cactorium/auto-orchestra/README.md

WIP thing, honestly just publishing just in case my laptop dies
