cactorium/auto-orchestra/pcb/transmitter/LSM303AGR_Footprint.pdf

LSM303AGR
LGA-12 (2x2x1 mm) Recommendation Footprint Design for HTC 1

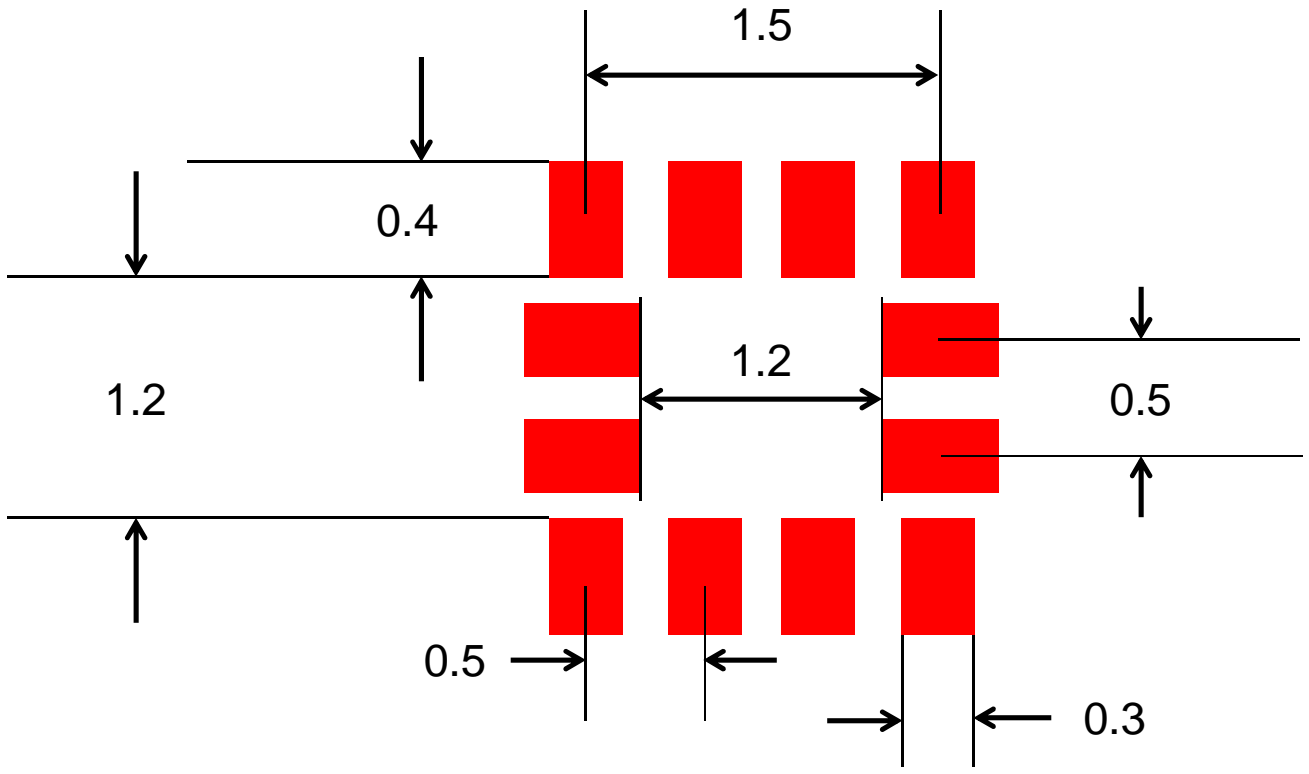
[picture p1: figure]

Presentation Title 29/07/2015

Note : Dimensions are shown in millimeters (mm)
