cactorium/auto-orchestra/pcb/transmitter/controller.pdf

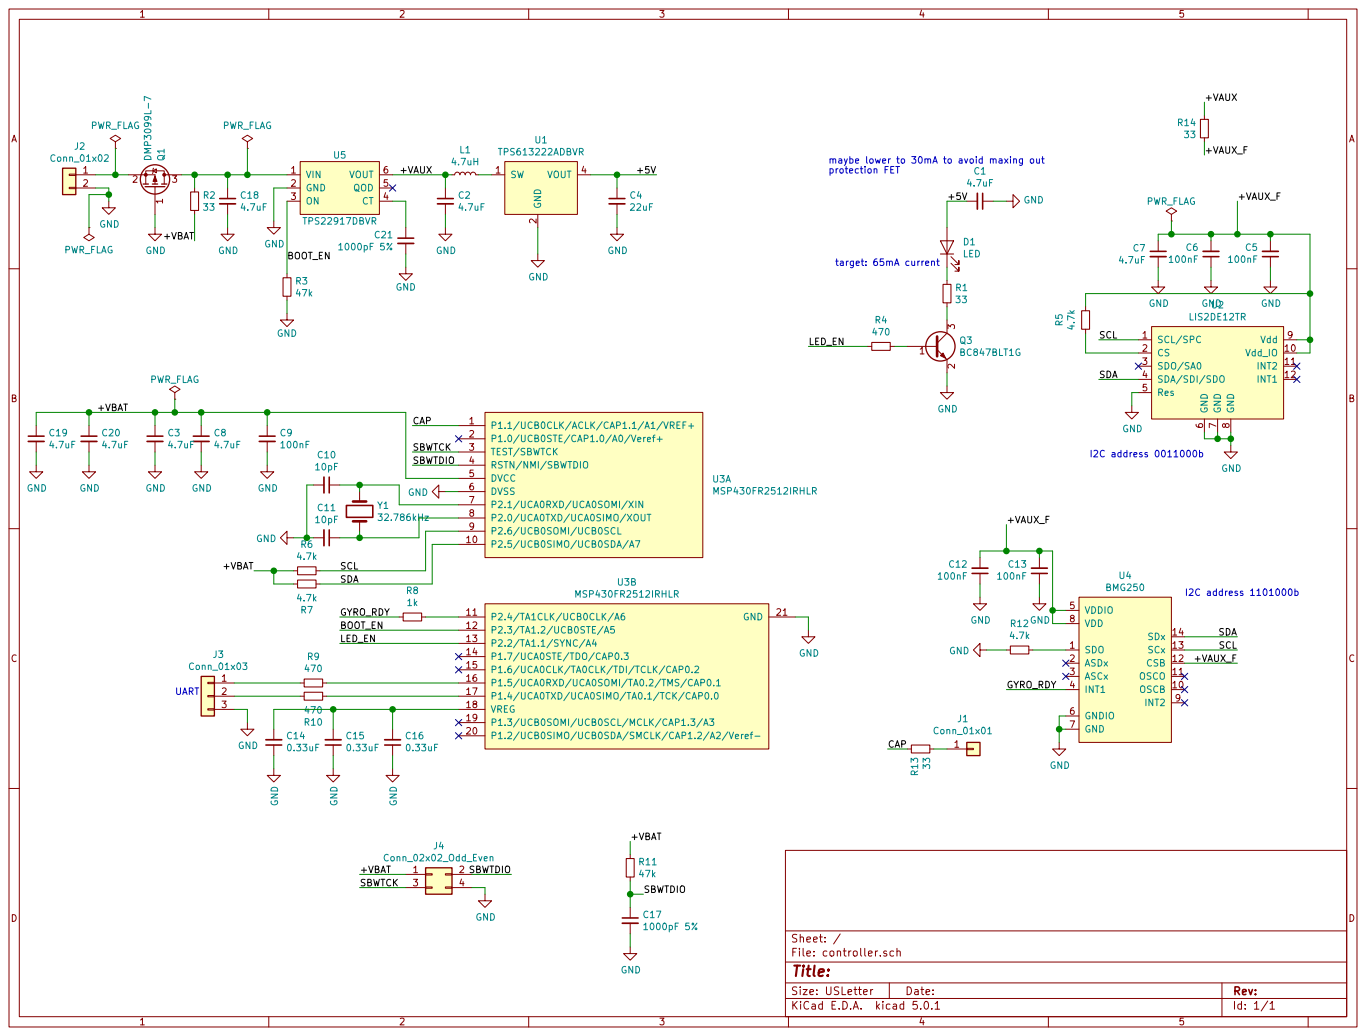
[picture p2: page 1]

4.7k maybe lower to 30mA to avoid maxing out

Id: 1/1 Title: File: controller.sch Sheet: /
