cactorium/auto-orchestra/pcb/receiver/receiver.pdf

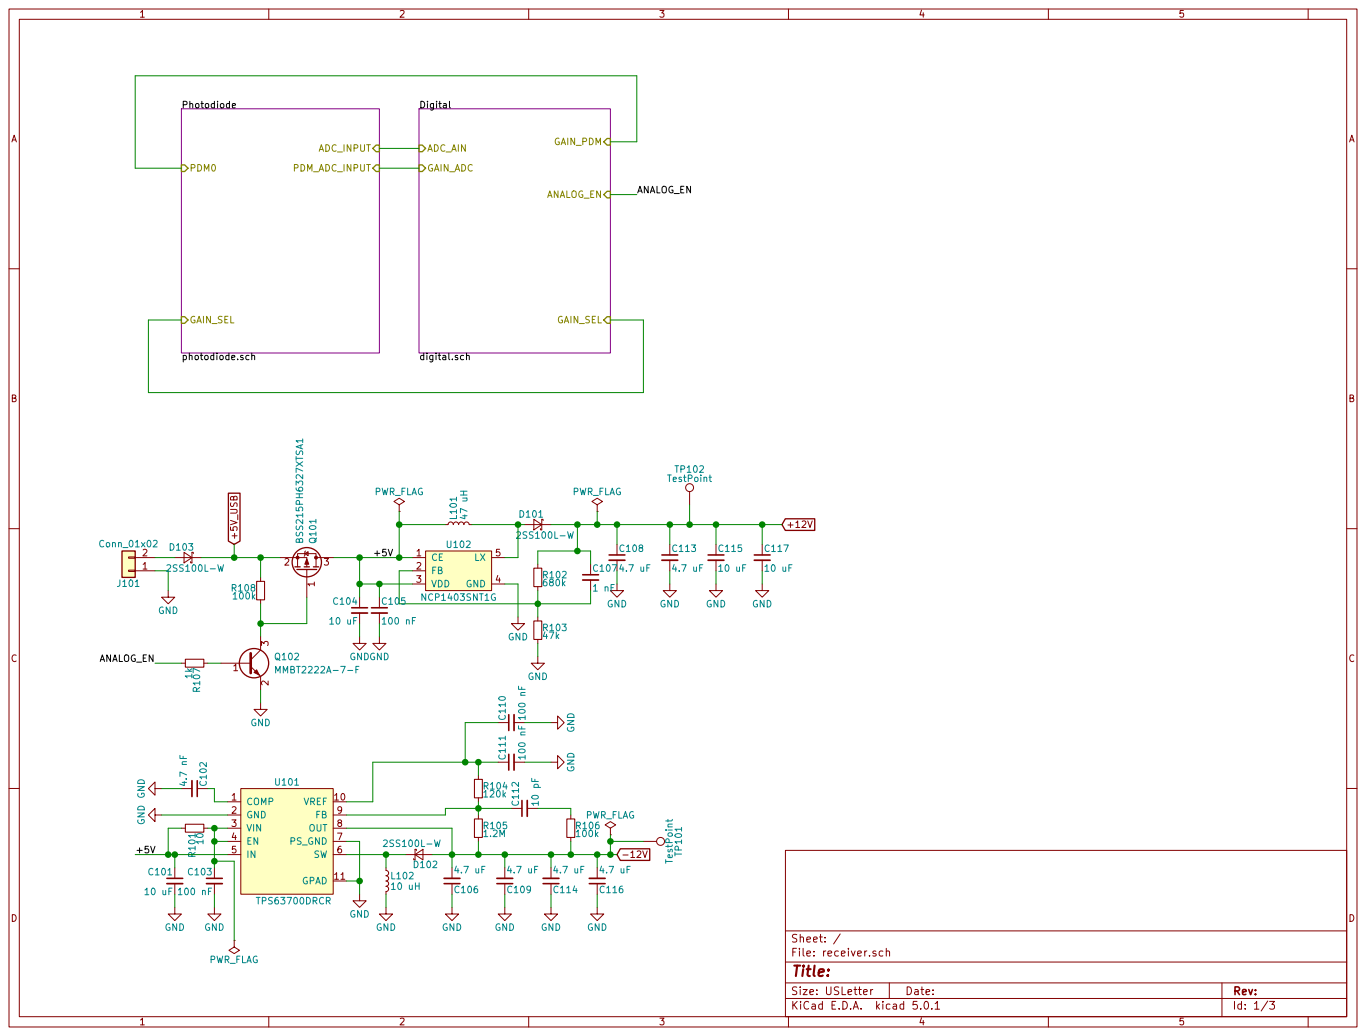
[picture p3: page 1]

Id: 1/3 Title: File: receiver.sch Sheet: /

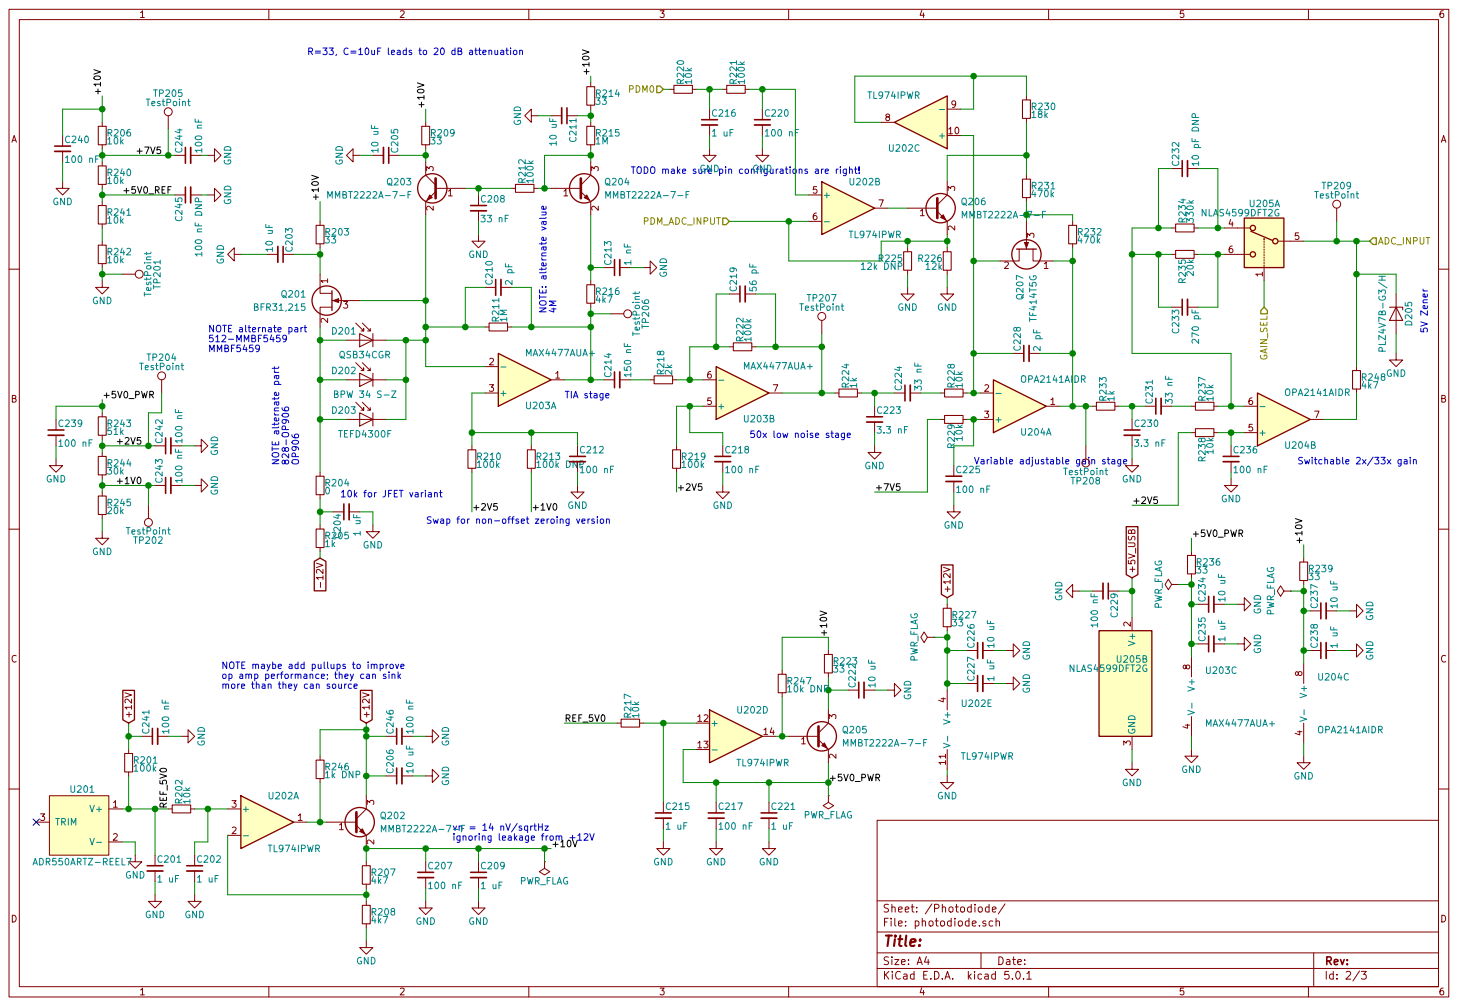
[picture p4: page 2]

2 3 Q202 MMBT2222A-7-F NOTE: alternate value 4M NOTE alternate part 828-OP906 OP906 TP207 TestPoint TP208 TestPoint TP209 TestPoint TP201 TestPoint TP205 TestPoint TP204 TestPoint TP202 TestPoint TP206 TestPoint

Variable adjustable gain stage

10k DNP NOTE maybe add pullups to improve
op amp performance; they can sink

File: photodiode.sch Sheet: /Photodiode/
Id: 2/3 Title:

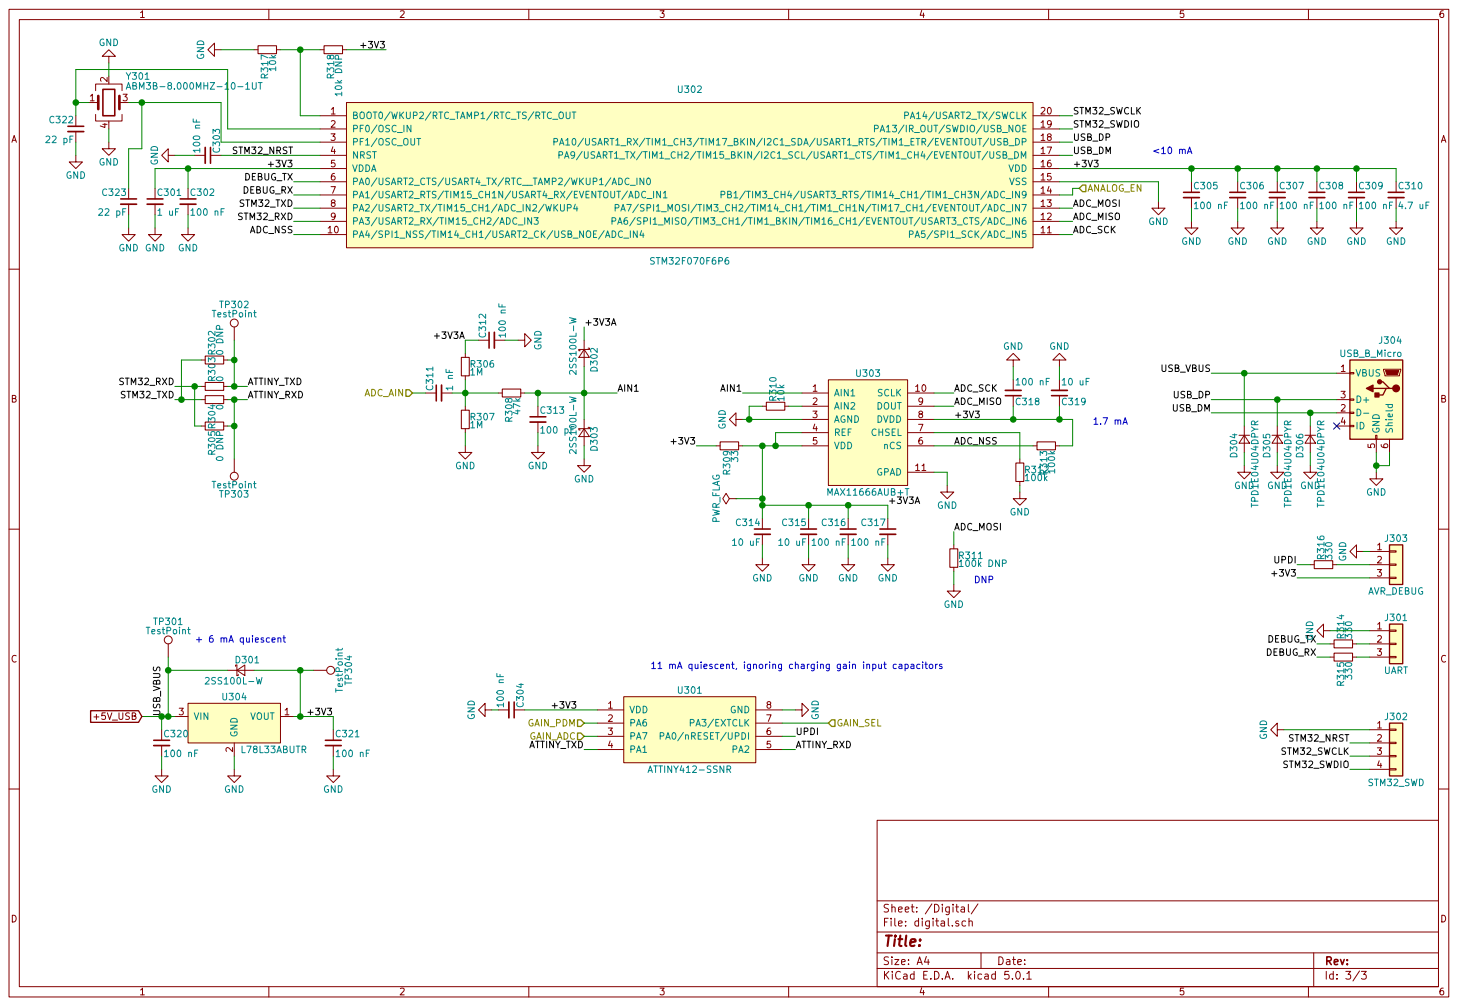
[picture p5: page 3]

11 mA quiescent, ignoring charging gain input capacitors
