cactorium/auto-orchestra/pcb/motor-driver/peripherals.kicad_pcb

## KiCad design pcb/motor-driver/peripherals.kicad_pcb (2018-12-05)

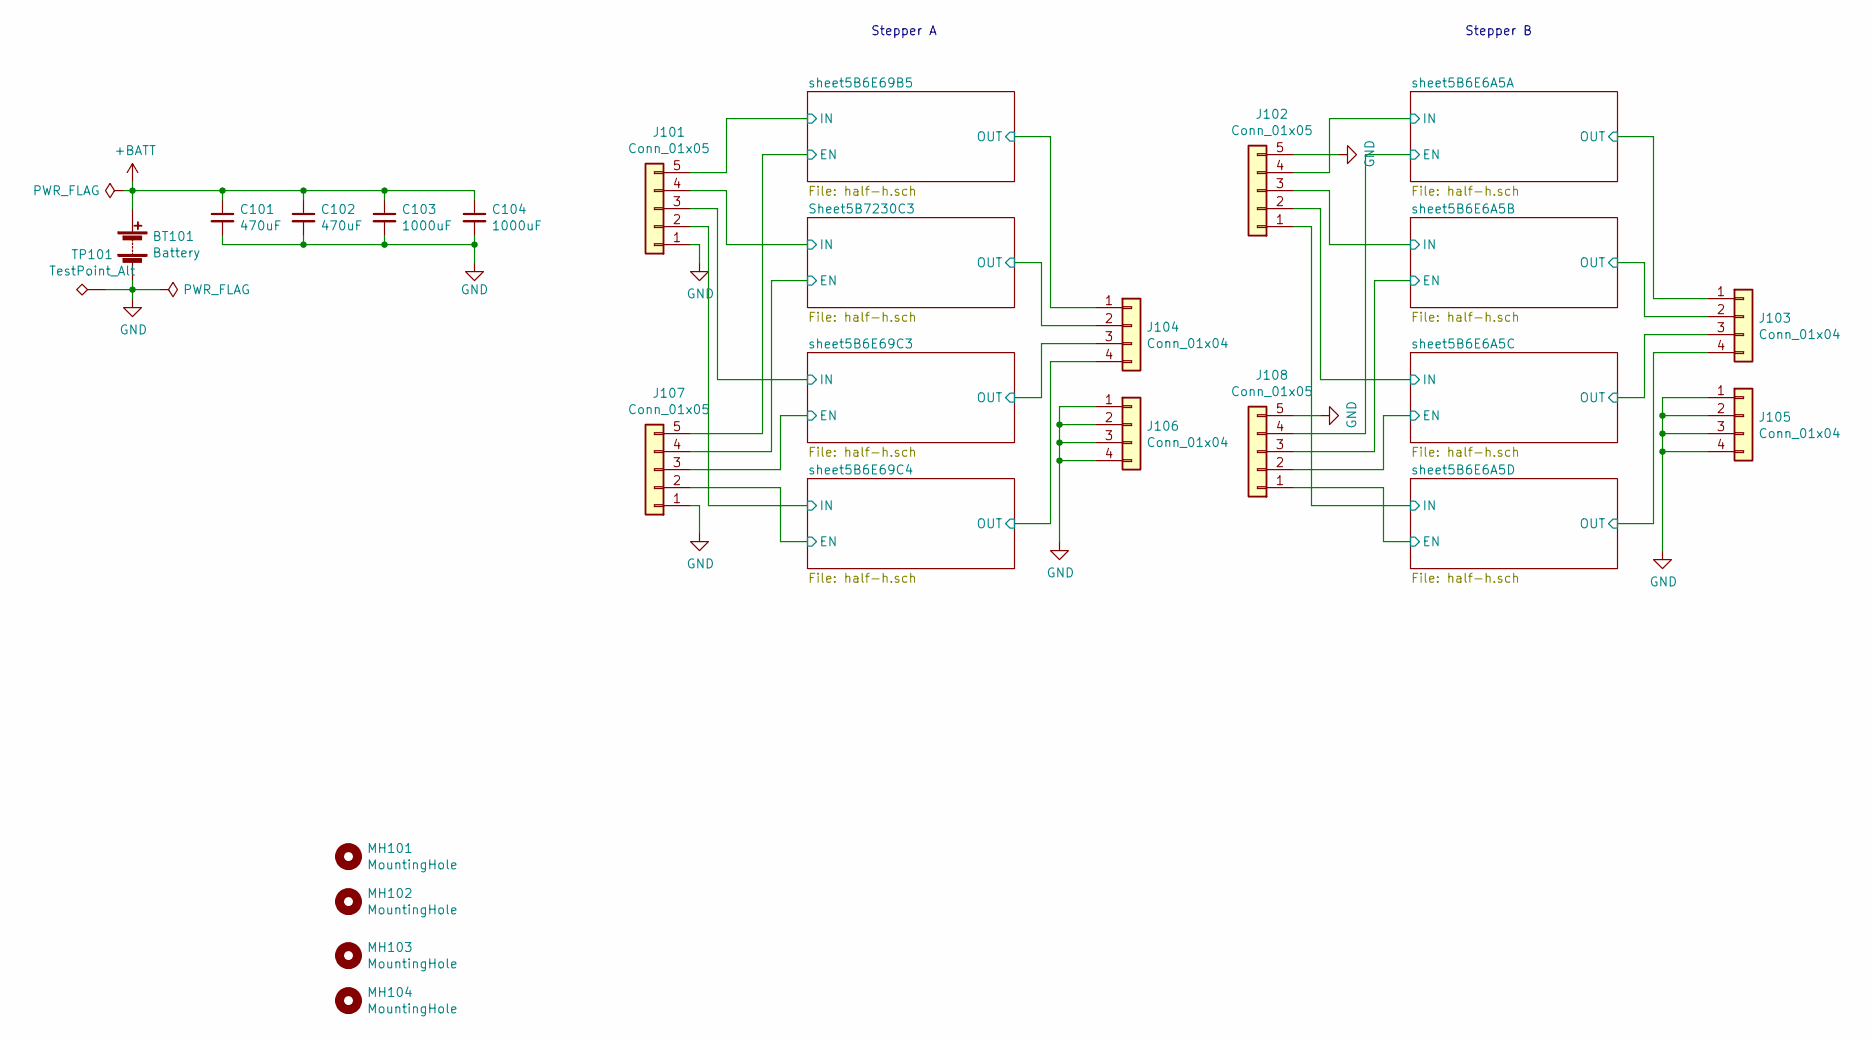
[picture p6: schematic peripherals.sch]

Parts:
BT101: Battery; Conn-2-8mmx6mm; Mouser NoPart
C101, C102: 470uF; CP_Radial_D10.0mm_P5.00mm; Mouser 140-REA471M1EBK1012P
C103, C104: 1000uF; CP_Radial_D18.0mm_P7.50mm; Mouser 598-108SAK025M
J101, J102, J107, J108: Conn_01x05; Socket_Strip_Straight_1x05_Pitch2.54mm; Mouser NoPart
J103, J104, J105, J106: Conn_01x04; Conn-4-8mmx3mm; Mouser NoPart
MH101, MH102, MH103, MH104: MountingHole; MountingHole_5.3mm_M5_Pad; Mouser NoPart
TP101: TestPoint_Alt; Measurement_Point_Round-SMD-Pad_Small; Mouser NoPart

Connections:
+BATT: BT101.1 (+), C101.1, C102.1, C103.1, C104.1; also elsewhere on the board
/Sheet5B7230C3/EN: J107.4; also elsewhere on the board
/Sheet5B7230C3/IN: J101.4; also elsewhere on the board
/Sheet5B7230C3/OUT: J104.2; also elsewhere on the board
/sheet5B6E6A5A/EN: J108.4; also elsewhere on the board
/sheet5B6E6A5A/IN: J102.4; also elsewhere on the board
/sheet5B6E6A5A/OUT: J103.1; also elsewhere on the board
/sheet5B6E6A5B/EN: J108.3; also elsewhere on the board
/sheet5B6E6A5B/IN: J102.3; also elsewhere on the board
/sheet5B6E6A5B/OUT: J103.2; also elsewhere on the board
/sheet5B6E6A5C/EN: J108.2; also elsewhere on the board
/sheet5B6E6A5C/IN: J102.2; also elsewhere on the board
/sheet5B6E6A5C/OUT: J103.3; also elsewhere on the board
/sheet5B6E6A5D/EN: J108.1; also elsewhere on the board
/sheet5B6E6A5D/IN: J102.1; also elsewhere on the board
/sheet5B6E6A5D/OUT: J103.4; also elsewhere on the board
/sheet5B6E69B5/EN: J107.5; also elsewhere on the board
/sheet5B6E69B5/IN: J101.5; also elsewhere on the board
/sheet5B6E69B5/OUT: J104.1; also elsewhere on the board
/sheet5B6E69C3/EN: J107.3; also elsewhere on the board
/sheet5B6E69C3/IN: J101.3; also elsewhere on the board
/sheet5B6E69C3/OUT: J104.3; also elsewhere on the board
/sheet5B6E69C4/EN: J107.2; also elsewhere on the board
/sheet5B6E69C4/IN: J101.2; also elsewhere on the board
/sheet5B6E69C4/OUT: J104.4; also elsewhere on the board
GND: BT101.2 (-), C101.2, C102.2, C103.2, C104.2, J101.1, J102.5, J105.1, J105.2, J105.3, J105.4, J106.1, J106.2, J106.3, J106.4, J107.1, J108.5, TP101.1; also elsewhere on the board

Notes on the sheet:
Stepper A
Stepper B

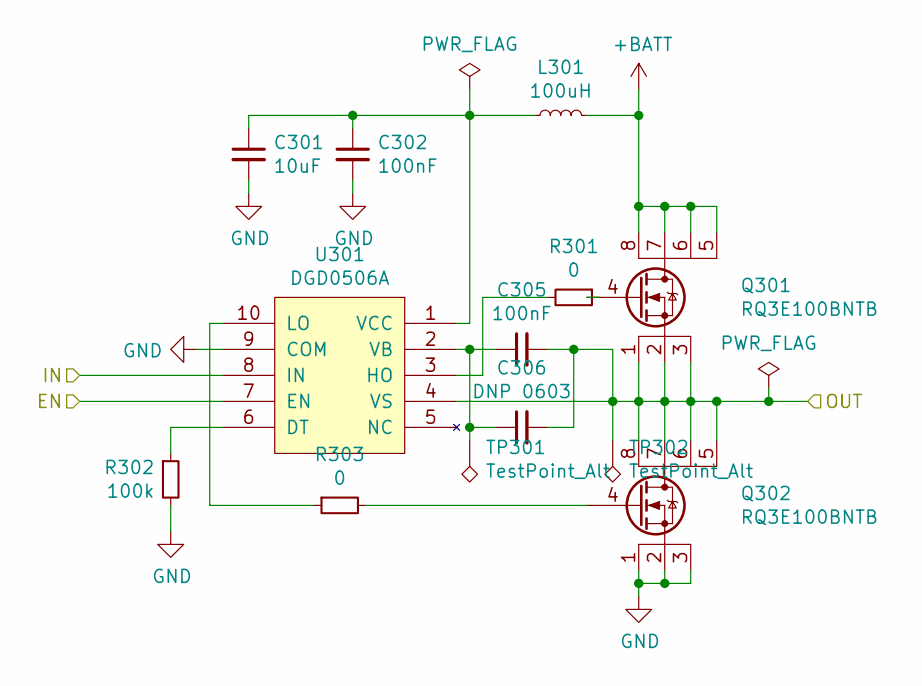
[picture p7: schematic half-h.sch]

Parts:
C201: 10uF; CP_Elec_4x5.7; Mouser 710-865080440002
C202, C205: 100nF; C_0402; Mouser 710-885012105018
C206: DNP 0603; C_0603_HandSoldering; Mouser NoPart
L201: 100uH; R_0805_HandSoldering; Mouser 810-MLZ2012N101LT000
Q201, Q202: RQ3E100BNTB; Rohm-HSMT8; Mouser 755-RQ3E100BNTB
R201, R203: 0; R_0603_HandSoldering; Mouser 755-SFR03EZPJ000
R202: 100k; R_0402; Mouser 603-RC0402JR-13100KL
TP201, TP202: TestPoint_Alt; Measurement_Point_Round-SMD-Pad_Small; Mouser NoPart
U201: DGD0506A; Diodes-MSOP10; Mouser 621-DGD0506AM10-13

Connections:
+BATT: L201.2, Q201.5 (D), Q201.6 (D), Q201.7 (D), Q201.8 (D); also elsewhere on the board
/Sheet5B7230C3/EN: U201.7 (EN); also elsewhere on the board
/Sheet5B7230C3/IN: U201.8 (IN); also elsewhere on the board
/Sheet5B7230C3/OUT: C205.2, C206.2, Q201.1 (S), Q201.2 (S), Q201.3 (S), Q202.5 (D), Q202.6 (D), Q202.7 (D), Q202.8 (D), TP202.1, U201.4 (VS); also elsewhere on the board
GND: C201.2, C202.2, Q202.1 (S), Q202.2 (S), Q202.3 (S), R202.2, U201.9 (COM); also elsewhere on the board
unnamed: C201.1, C202.1, L201.1, U201.1 (VCC)
unnamed: C205.1, C206.1, TP201.1, U201.2 (VB)
unnamed: Q201.4 (G), R201.1
unnamed: Q202.4 (G), R203.2
unnamed: R201.2, U201.3 (HO)
unnamed: R202.1, U201.6 (DT)
unnamed: R203.1, U201.10 (LO)

Parts of its further copies:
C301, C401, C501, C601, C701, C801, C901: 10uF; CP_Elec_4x5.7; Mouser 710-865080440002
C302, C305, C402, C405, C502, C505, C602, C605, C702, C705, C802, C805, C902, C905: 100nF; C_0402; Mouser 710-885012105018
C306, C406, C506, C606, C706, C806, C906: DNP 0603; C_0603_HandSoldering; Mouser NoPart
L301, L401, L501, L601, L701, L801, L901: 100uH; R_0805_HandSoldering; Mouser 810-MLZ2012N101LT000
Q301, Q302, Q401, Q402, Q501, Q502, Q601, Q602, Q701, Q702, Q801, Q802, Q901, Q902: RQ3E100BNTB; Rohm-HSMT8; Mouser 755-RQ3E100BNTB
R301, R303, R401, R403, R501, R503, R601, R603, R701, R703, R801, R803, R901, R903: 0; R_0603_HandSoldering; Mouser 755-SFR03EZPJ000
R302, R402, R502, R602, R702, R802, R902: 100k; R_0402; Mouser 603-RC0402JR-13100KL
TP301, TP302, TP401, TP402, TP501, TP502, TP601, TP602, TP701, TP702, TP801, TP802, TP901, TP902: TestPoint_Alt; Measurement_Point_Round-SMD-Pad_Small; Mouser NoPart
U301, U401, U501, U601, U701, U801, U901: DGD0506A; Diodes-MSOP10; Mouser 621-DGD0506AM10-13

Connections of its further copies:
+BATT: L301.2, L401.2, L501.2, L601.2, L701.2, L801.2, L901.2, Q301.5 (D), Q301.6 (D), Q301.7 (D), Q301.8 (D), Q401.5 (D), Q401.6 (D), Q401.7 (D), Q401.8 (D), Q501.5 (D), Q501.6 (D), Q501.7 (D), Q501.8 (D), Q601.5 (D), Q601.6 (D), Q601.7 (D), Q601.8 (D), Q701.5 (D), Q701.6 (D), Q701.7 (D), Q701.8 (D), Q801.5 (D), Q801.6 (D), Q801.7 (D), Q801.8 (D), Q901.5 (D), Q901.6 (D), Q901.7 (D), Q901.8 (D); also elsewhere on the board
/sheet5B6E6A5A/EN: U601.7 (EN); also elsewhere on the board
/sheet5B6E6A5A/IN: U601.8 (IN); also elsewhere on the board
/sheet5B6E6A5A/OUT: C605.2, C606.2, Q601.1 (S), Q601.2 (S), Q601.3 (S), Q602.5 (D), Q602.6 (D), Q602.7 (D), Q602.8 (D), TP602.1, U601.4 (VS); also elsewhere on the board
/sheet5B6E6A5B/EN: U701.7 (EN); also elsewhere on the board
/sheet5B6E6A5B/IN: U701.8 (IN); also elsewhere on the board
/sheet5B6E6A5B/OUT: C705.2, C706.2, Q701.1 (S), Q701.2 (S), Q701.3 (S), Q702.5 (D), Q702.6 (D), Q702.7 (D), Q702.8 (D), TP702.1, U701.4 (VS); also elsewhere on the board
/sheet5B6E6A5C/EN: U801.7 (EN); also elsewhere on the board
/sheet5B6E6A5C/IN: U801.8 (IN); also elsewhere on the board
/sheet5B6E6A5C/OUT: C805.2, C806.2, Q801.1 (S), Q801.2 (S), Q801.3 (S), Q802.5 (D), Q802.6 (D), Q802.7 (D), Q802.8 (D), TP802.1, U801.4 (VS); also elsewhere on the board
/sheet5B6E6A5D/EN: U901.7 (EN); also elsewhere on the board
/sheet5B6E6A5D/IN: U901.8 (IN); also elsewhere on the board
/sheet5B6E6A5D/OUT: C905.2, C906.2, Q901.1 (S), Q901.2 (S), Q901.3 (S), Q902.5 (D), Q902.6 (D), Q902.7 (D), Q902.8 (D), TP902.1, U901.4 (VS); also elsewhere on the board
/sheet5B6E69B5/EN: U301.7 (EN); also elsewhere on the board
/sheet5B6E69B5/IN: U301.8 (IN); also elsewhere on the board
/sheet5B6E69B5/OUT: C305.2, C306.2, Q301.1 (S), Q301.2 (S), Q301.3 (S), Q302.5 (D), Q302.6 (D), Q302.7 (D), Q302.8 (D), TP302.1, U301.4 (VS); also elsewhere on the board
/sheet5B6E69C3/EN: U401.7 (EN); also elsewhere on the board
/sheet5B6E69C3/IN: U401.8 (IN); also elsewhere on the board
/sheet5B6E69C3/OUT: C405.2, C406.2, Q401.1 (S), Q401.2 (S), Q401.3 (S), Q402.5 (D), Q402.6 (D), Q402.7 (D), Q402.8 (D), TP402.1, U401.4 (VS); also elsewhere on the board
/sheet5B6E69C4/EN: U501.7 (EN); also elsewhere on the board
/sheet5B6E69C4/IN: U501.8 (IN); also elsewhere on the board
/sheet5B6E69C4/OUT: C505.2, C506.2, Q501.1 (S), Q501.2 (S), Q501.3 (S), Q502.5 (D), Q502.6 (D), Q502.7 (D), Q502.8 (D), TP502.1, U501.4 (VS); also elsewhere on the board
GND: C301.2, C302.2, C401.2, C402.2, C501.2, C502.2, C601.2, C602.2, C701.2, C702.2, C801.2, C802.2, C901.2, C902.2, Q302.1 (S), Q302.2 (S), Q302.3 (S), Q402.1 (S), Q402.2 (S), Q402.3 (S), Q502.1 (S), Q502.2 (S), Q502.3 (S), Q602.1 (S), Q602.2 (S), Q602.3 (S), Q702.1 (S), Q702.2 (S), Q702.3 (S), Q802.1 (S), Q802.2 (S), Q802.3 (S), Q902.1 (S), Q902.2 (S), Q902.3 (S), R302.2, R402.2, R502.2, R602.2, R702.2, R802.2, R902.2, U301.9 (COM), U401.9 (COM), U501.9 (COM), U601.9 (COM), U701.9 (COM), U801.9 (COM), U901.9 (COM); also elsewhere on the board
unnamed: C301.1, C302.1, L301.1, U301.1 (VCC)
unnamed: C305.1, C306.1, TP301.1, U301.2 (VB)
unnamed: C401.1, C402.1, L401.1, U401.1 (VCC)
unnamed: C405.1, C406.1, TP401.1, U401.2 (VB)
unnamed: C501.1, C502.1, L501.1, U501.1 (VCC)
unnamed: C505.1, C506.1, TP501.1, U501.2 (VB)
unnamed: C601.1, C602.1, L601.1, U601.1 (VCC)
unnamed: C605.1, C606.1, TP601.1, U601.2 (VB)
unnamed: C701.1, C702.1, L701.1, U701.1 (VCC)
unnamed: C705.1, C706.1, TP701.1, U701.2 (VB)
unnamed: C801.1, C802.1, L801.1, U801.1 (VCC)
unnamed: C805.1, C806.1, TP801.1, U801.2 (VB)
unnamed: C901.1, C902.1, L901.1, U901.1 (VCC)
unnamed: C905.1, C906.1, TP901.1, U901.2 (VB)
unnamed: Q301.4 (G), R301.1
unnamed: Q302.4 (G), R303.2
unnamed: Q401.4 (G), R401.1
unnamed: Q402.4 (G), R403.2
unnamed: Q501.4 (G), R501.1
unnamed: Q502.4 (G), R503.2
unnamed: Q601.4 (G), R601.1
unnamed: Q602.4 (G), R603.2
unnamed: Q701.4 (G), R701.1
unnamed: Q702.4 (G), R703.2
unnamed: Q801.4 (G), R801.1
unnamed: Q802.4 (G), R803.2
unnamed: Q901.4 (G), R901.1
unnamed: Q902.4 (G), R903.2
unnamed: R301.2, U301.3 (HO)
unnamed: R302.1, U301.6 (DT)
unnamed: R303.1, U301.10 (LO)
unnamed: R401.2, U401.3 (HO)
unnamed: R402.1, U401.6 (DT)
unnamed: R403.1, U401.10 (LO)
unnamed: R501.2, U501.3 (HO)
unnamed: R502.1, U501.6 (DT)
unnamed: R503.1, U501.10 (LO)
unnamed: R601.2, U601.3 (HO)
unnamed: R602.1, U601.6 (DT)
unnamed: R603.1, U601.10 (LO)
unnamed: R701.2, U701.3 (HO)
unnamed: R702.1, U701.6 (DT)
unnamed: R703.1, U701.10 (LO)
unnamed: R801.2, U801.3 (HO)
unnamed: R802.1, U801.6 (DT)
unnamed: R803.1, U801.10 (LO)
unnamed: R901.2, U901.3 (HO)
unnamed: R902.1, U901.6 (DT)
unnamed: R903.1, U901.10 (LO)

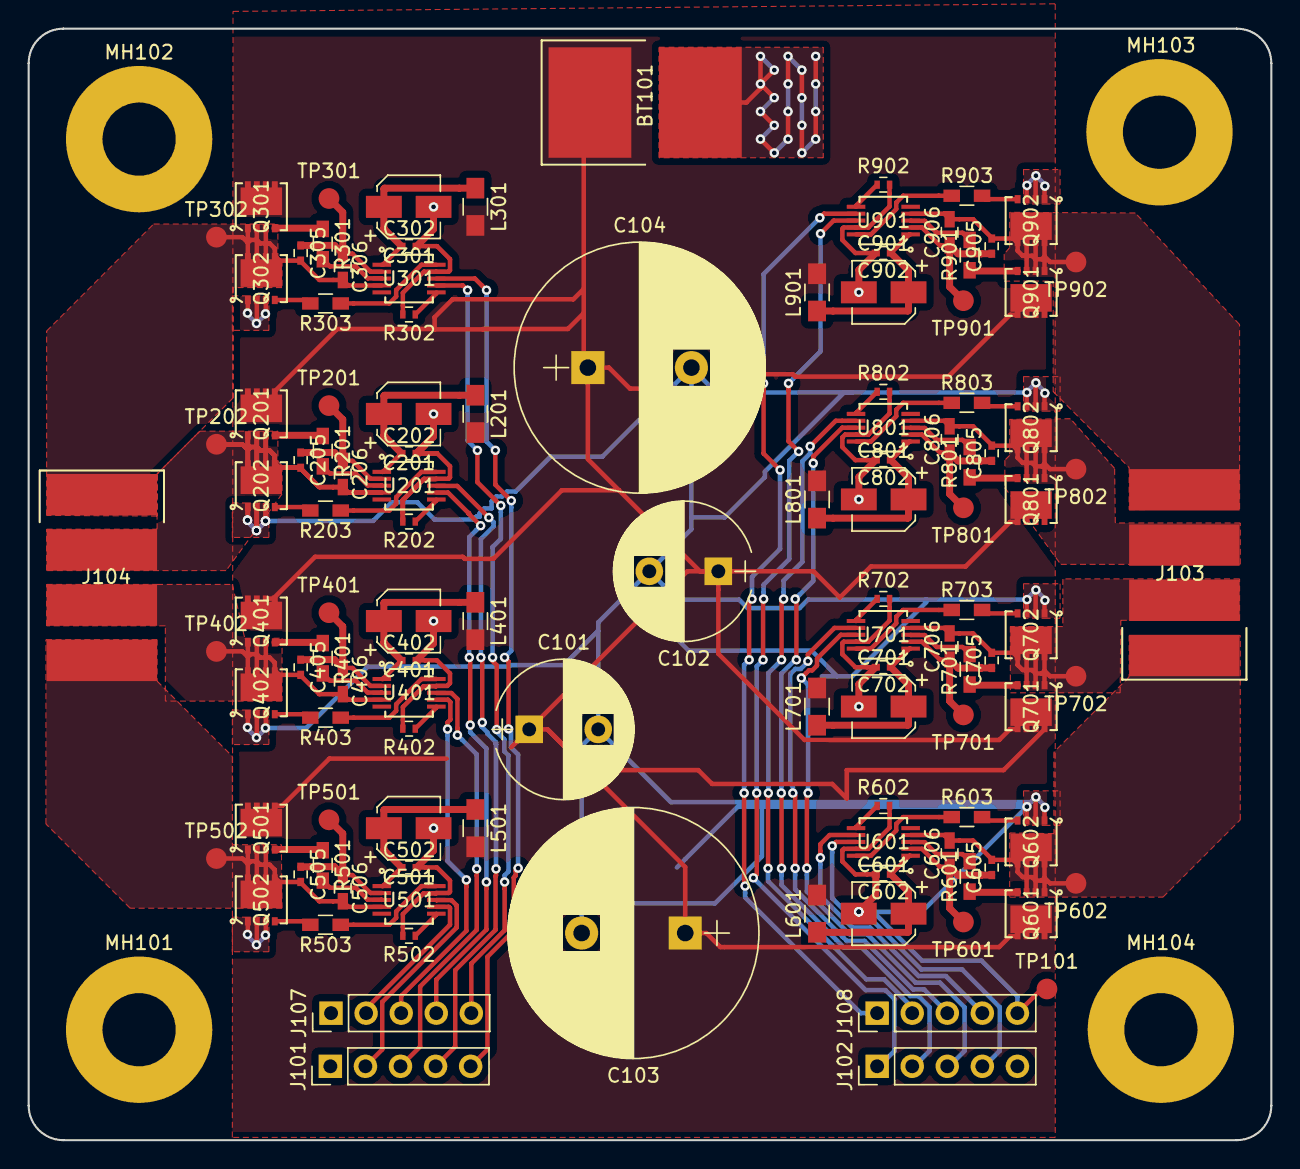
[picture p8: board peripherals.kicad_pcb from above]

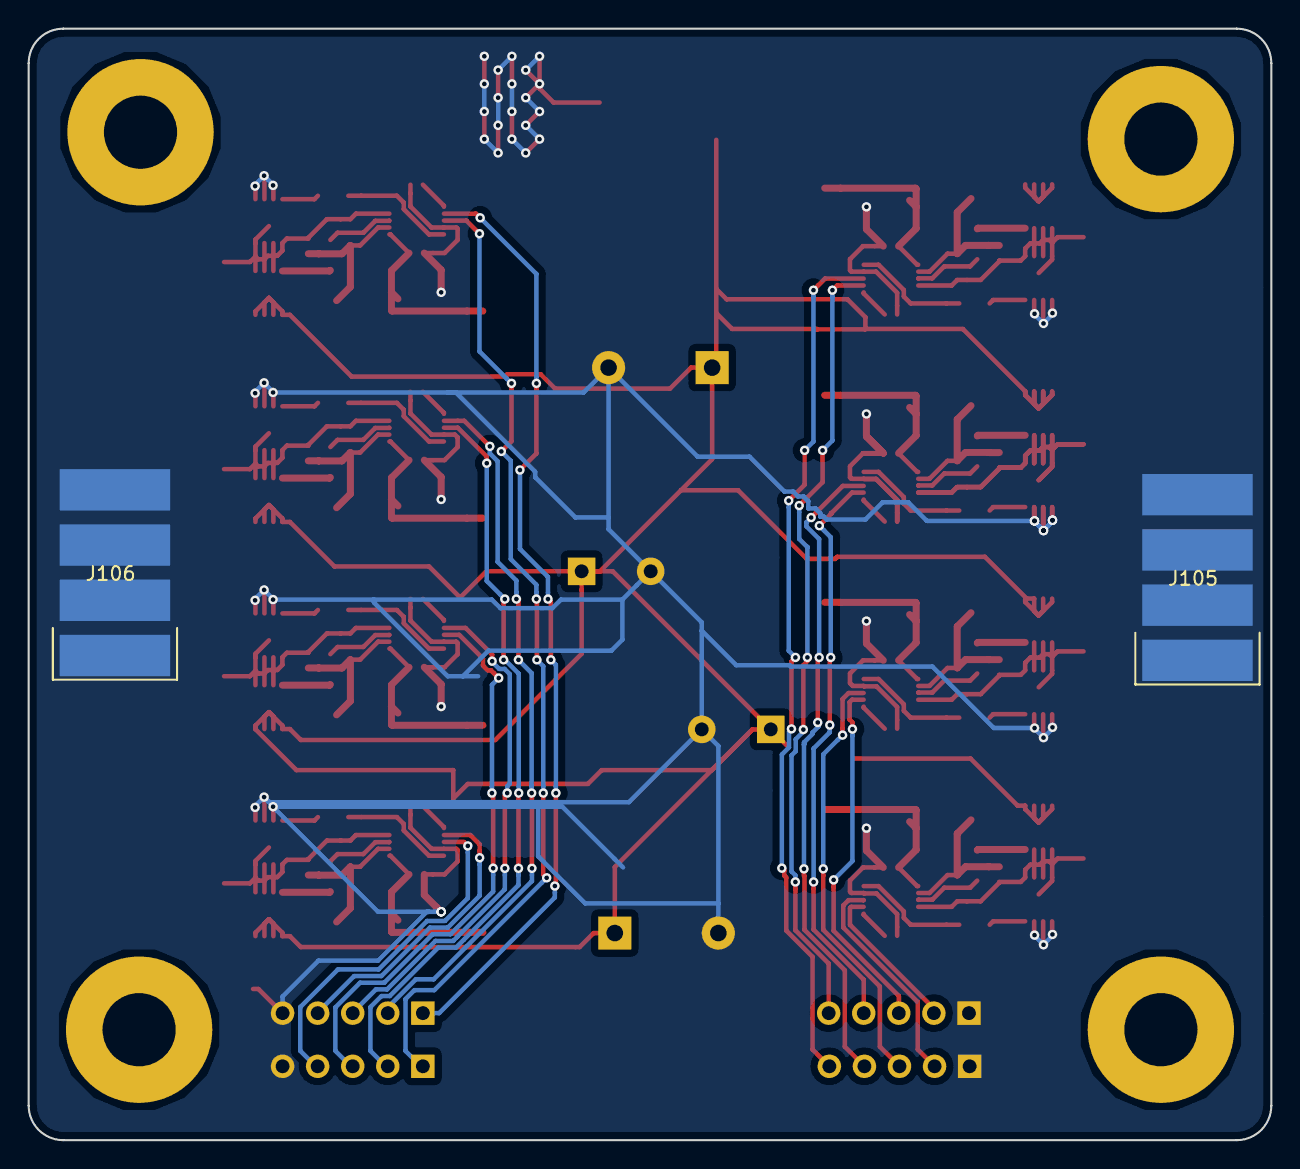
[picture p9: board peripherals.kicad_pcb from below]

Board: 2 copper layers, 90.0 x 80.5 mm, 122 parts (2 on the bottom side), 82 nets.
