cactorium/auto-orchestra/pcb/transmitter/controller.kicad_pcb

## KiCad design pcb/transmitter/controller.kicad_pcb (2018-12-09)

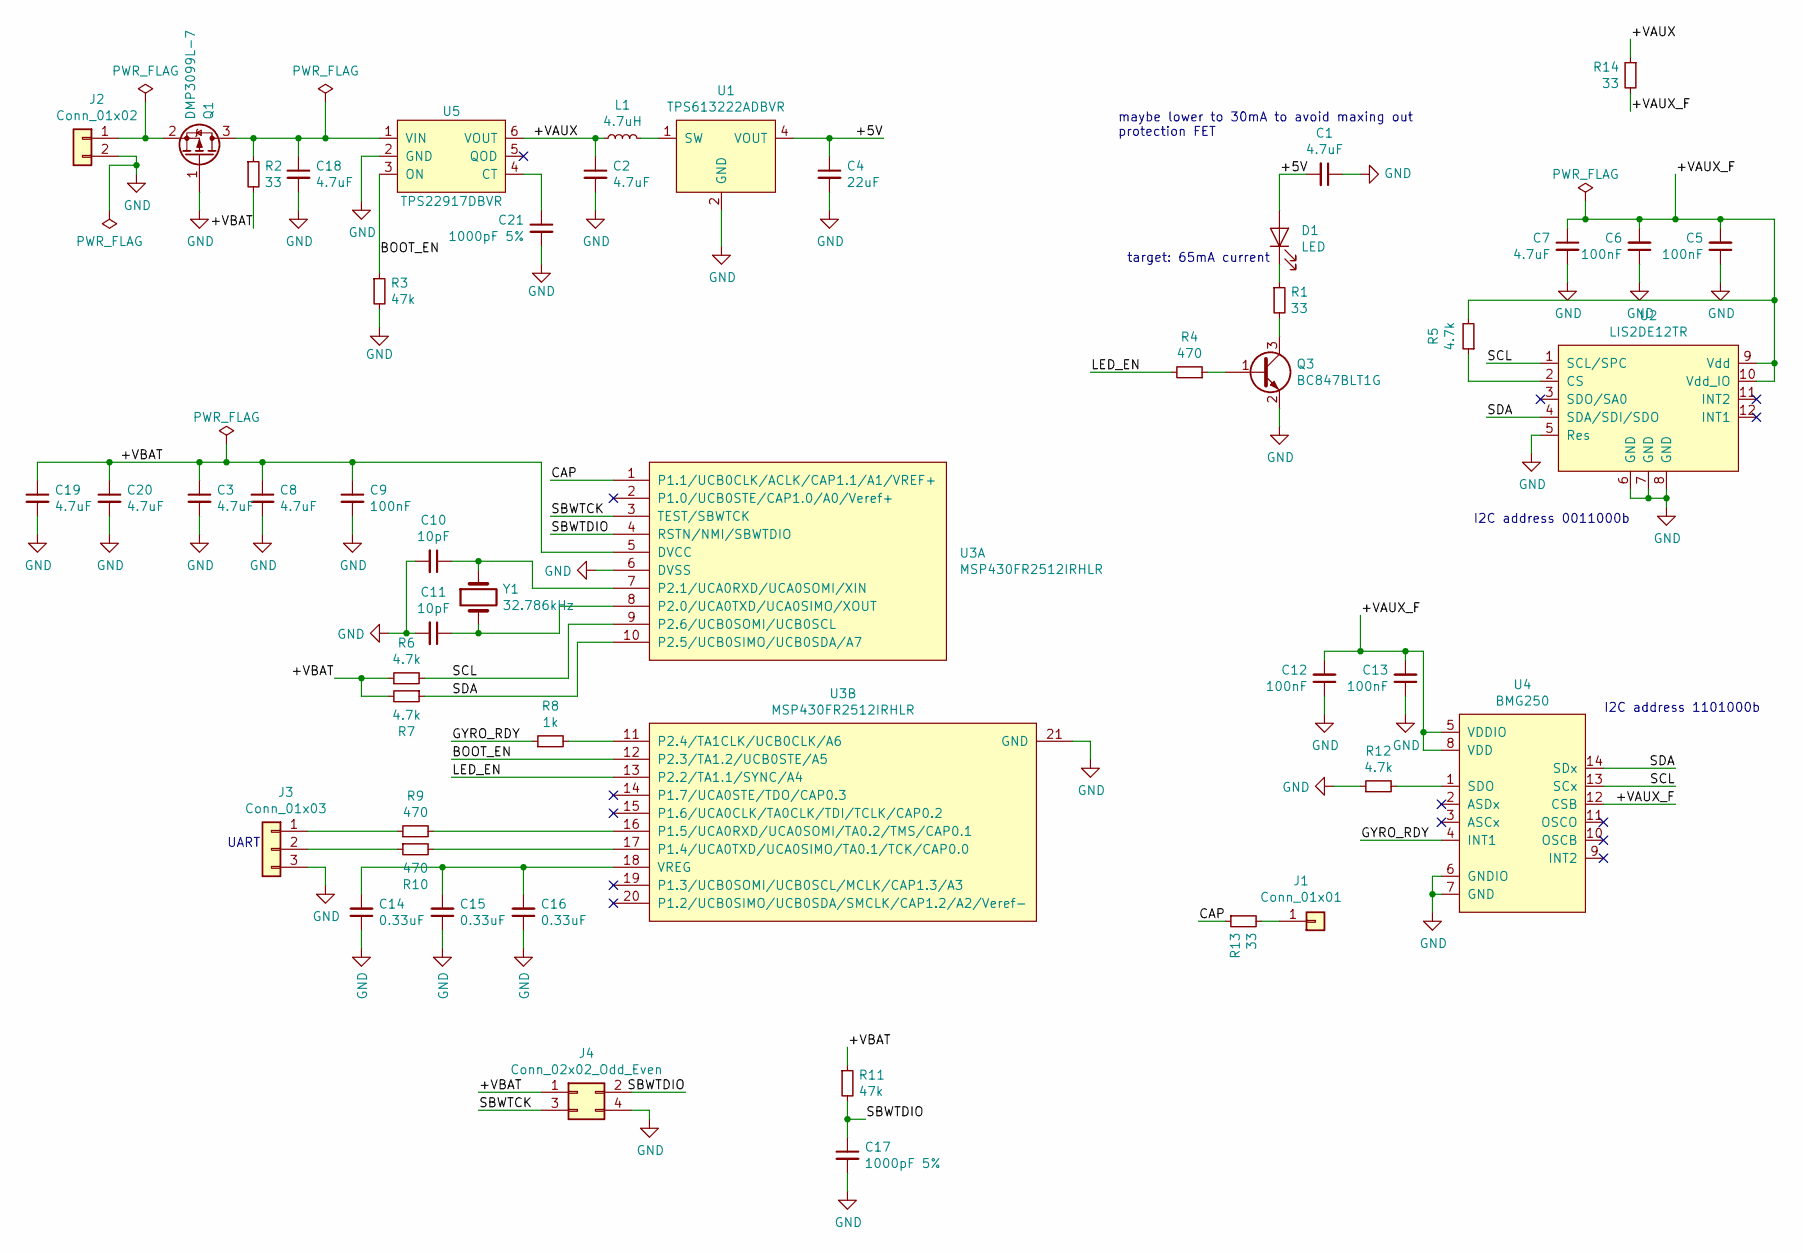
[picture p10: schematic controller.sch]

Parts:
C1, C2, C3, C7, C8, C18, C19, C20: 4.7uF; C_0603_HandSoldering; Mouser 810-CGB3B1X5R1A475MC
C4: 22uF; C_0805_HandSoldering; Mouser 963-LMK212BJ226MG-T
C5, C6, C9, C12, C13: 100nF; C_0402; Mouser 710-885012105018
C10, C11: 10pF; C_0402; Mouser 81-GCQ1555C1H100RB1D
C14, C15, C16: 0.33uF; C_0402; Mouser 710-885012105003
C17, C21: 1000pF 5%; C_0805_HandSoldering; Mouser 710-885012207033
D1: LED; Socket_Strip_Straight_1x02_Pitch1.27mm; Mouser 941-JB3030W00A0UC435
J1: Conn_01x01; Socket_Strip_Straight_1x01_Pitch2.54mm; Mouser NoPart
J2: Conn_01x02; Socket_Strip_Straight_1x02_Pitch1.27mm; Mouser NoPart
J3: Conn_01x03; Socket_Strip_Straight_1x03_Pitch1.27mm; Mouser NoPart
J4: Conn_02x02_Odd_Even; Socket_Strip_Straight_2x02_Pitch1.27mm; Mouser NoPart
L1: 4.7uH; Inductor_Taiyo-Yuden_NR-24xx_HandSoldering; Mouser 963-NRH2410T4R7MN
Q1: DMP3099L-7; SOT-23_Handsoldering; Mouser 621-DMP3099L-7
Q3: BC847BLT1G; SOT-23_Handsoldering; Mouser 863-BC847BLT1G
R1: 33; R_0603_HandSoldering; Mouser 755-ESR03EZPJ330
R2, R13, R14: 33; R_0603_HandSoldering
R3, R11: 47k; R_0603_HandSoldering; Mouser 603-RC0603JR-0747KL
R4, R9, R10: 470; R_0402; Mouser 791-RMC1/16S-471JTH
R5, R6, R7, R12: 4.7k; R_0402; Mouser 603-RT0402FRE074K7L
R8: 1k; R_0603_HandSoldering; Mouser 755-ESR03EZPJ102
U1: TPS613222ADBVR; SOT-23-5_HandSoldering; Mouser 595-TPS613222ADBVR
U2: LIS2DE12TR; ST_LGA12; Mouser 511-LIS2DE12TR
U3: MSP430FR2512IRHLR; TI_MSP430_VQFN20; Mouser 595-430FR2512IRHLR
U4: BMG250; Bosch_LGA14; Mouser 262-BMG250
U5: TPS22917DBVR; SOT-23-6_Handsoldering; Mouser 595-TPS22917DBVR
Y1: 32.786kHz; Crystal_DS26_d2.0mm_l6.0mm_Horizontal; Mouser 520-ECS327-6-13-X

Connections:
/+5V: C1.2, C4.1, D1.2 (A), U1.4 (VOUT)
/+VAUX: C2.1, L1.1, R14.1, U5.6 (VOUT)
/+VAUX_F: C5.2, C6.2, C7.1, C12.2, C13.2, R5.2, R14.2, U2.9 (Vdd), U2.10 (Vdd_IO), U4.5 (VDDIO), U4.8 (VDD), U4.12 (CSB)
/+VBAT: C3.1, C8.1, C9.1, C19.1, C20.1, J4.1, R2.2, R6.1, R7.2, R11.1, U3.5 (DVCC)
/BOOT_EN: R3.1, U3.12 (P2.3/TA1.2/UCB0STE/A5), U5.3 (ON)
/CAP: R13.1, U3.1 (P1.1/UCB0CLK/ACLK/CAP1.1/A1/VREF+)
/GYRO_RDY: R8.1, U4.4 (INT1)
/LED_EN: R4.2, U3.13 (P2.2/TA1.1/SYNC/A4)
/SBWTCK: J4.3, U3.3 (TEST/SBWTCK)
/SBWTDIO: C17.1, J4.2, R11.2, U3.4 (RSTN/NMI/SBWTDIO)
/SCL: R6.2, U2.1 (SCL/SPC), U3.9 (P2.6/UCB0SOMI/UCB0SCL), U4.13 (SCx)
/SDA: R7.1, U2.4 (SDA/SDI/SDO), U3.10 (P2.5/UCB0SIMO/UCB0SDA/A7), U4.14 (SDx)
GND: C1.1, C2.2, C3.2, C4.2, C5.1, C6.1, C7.2, C8.2, C9.2, C10.2, C11.2, C12.1, C13.1, C14.1, C15.1, C16.1, C17.2, C18.2, C19.2, C20.2, C21.2, J2.2, J3.3, J4.4, Q1.1 (G), Q3.2 (E), R3.2, R12.1, U1.2 (GND), U2.5 (Res), U2.6 (GND), U2.7 (GND), U2.8 (GND), U3.6 (DVSS), U3.21 (GND), U4.6 (GNDIO), U4.7 (GND), U5.2 (GND)
unnamed: C10.1, U3.7 (P2.1/UCA0RXD/UCA0SOMI/XIN), Y1.1
unnamed: C11.1, U3.8 (P2.0/UCA0TXD/UCA0SIMO/XOUT), Y1.2
unnamed: C14.2, C15.2, C16.2, U3.18 (VREG)
unnamed: C18.1, Q1.3 (D), R2.1, U5.1 (VIN)
unnamed: C21.1, U5.4 (CT)
unnamed: D1.1 (K), R1.1
unnamed: J1.1, R13.2
unnamed: J2.1, Q1.2 (S)
unnamed: J3.1, R9.1
unnamed: J3.2, R10.1
unnamed: L1.2, U1.1 (SW)
unnamed: Q3.1 (B), R4.1
unnamed: Q3.3 (C), R1.2
unnamed: R5.1, U2.2 (CS)
unnamed: R8.2, U3.11 (P2.4/TA1CLK/UCB0CLK/A6)
unnamed: R9.2, U3.16 (P1.5/UCA0RXD/UCA0SOMI/TA0.2/TMS/CAP0.1)
unnamed: R10.2, U3.17 (P1.4/UCA0TXD/UCA0SIMO/TA0.1/TCK/CAP0.0)
unnamed: R12.2, U4.1 (SDO)

Notes on the sheet:
target: 65mA current
UART
I2C address 0011000b
I2C address 1101000b
maybe lower to 30mA to avoid maxing out protection FET

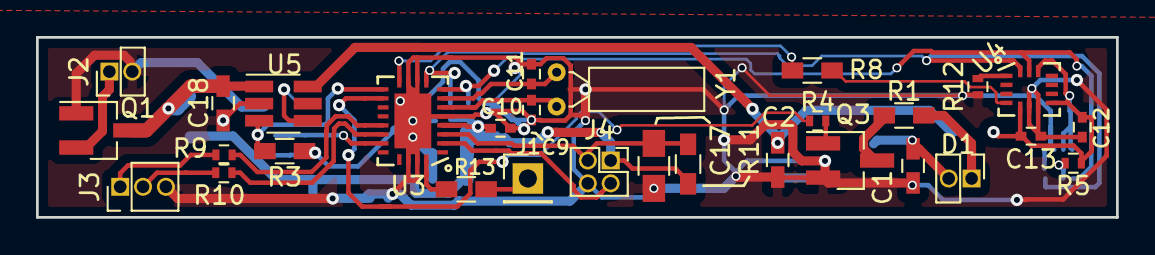
[picture p11: board controller.kicad_pcb from above]

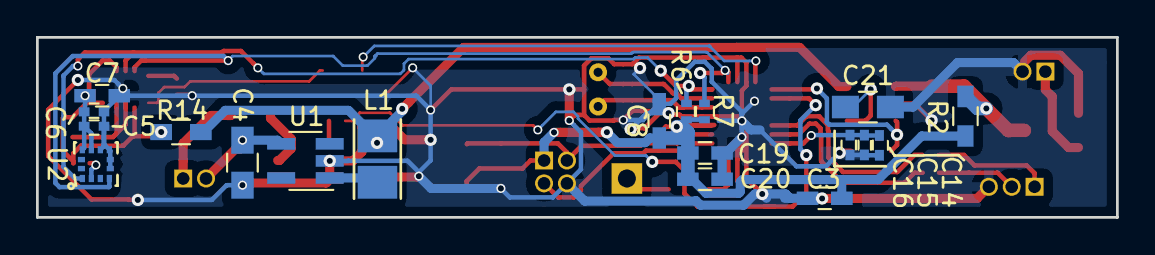
[picture p12: board controller.kicad_pcb from below]

Board: 2 copper layers, 60.0 x 10.0 mm, 49 parts (19 on the bottom side), 31 nets.
