cactorium/auto-orchestra/pcb/receiver/receiver.kicad_pcb

## KiCad design pcb/receiver/receiver.kicad_pcb (2018-12-05)

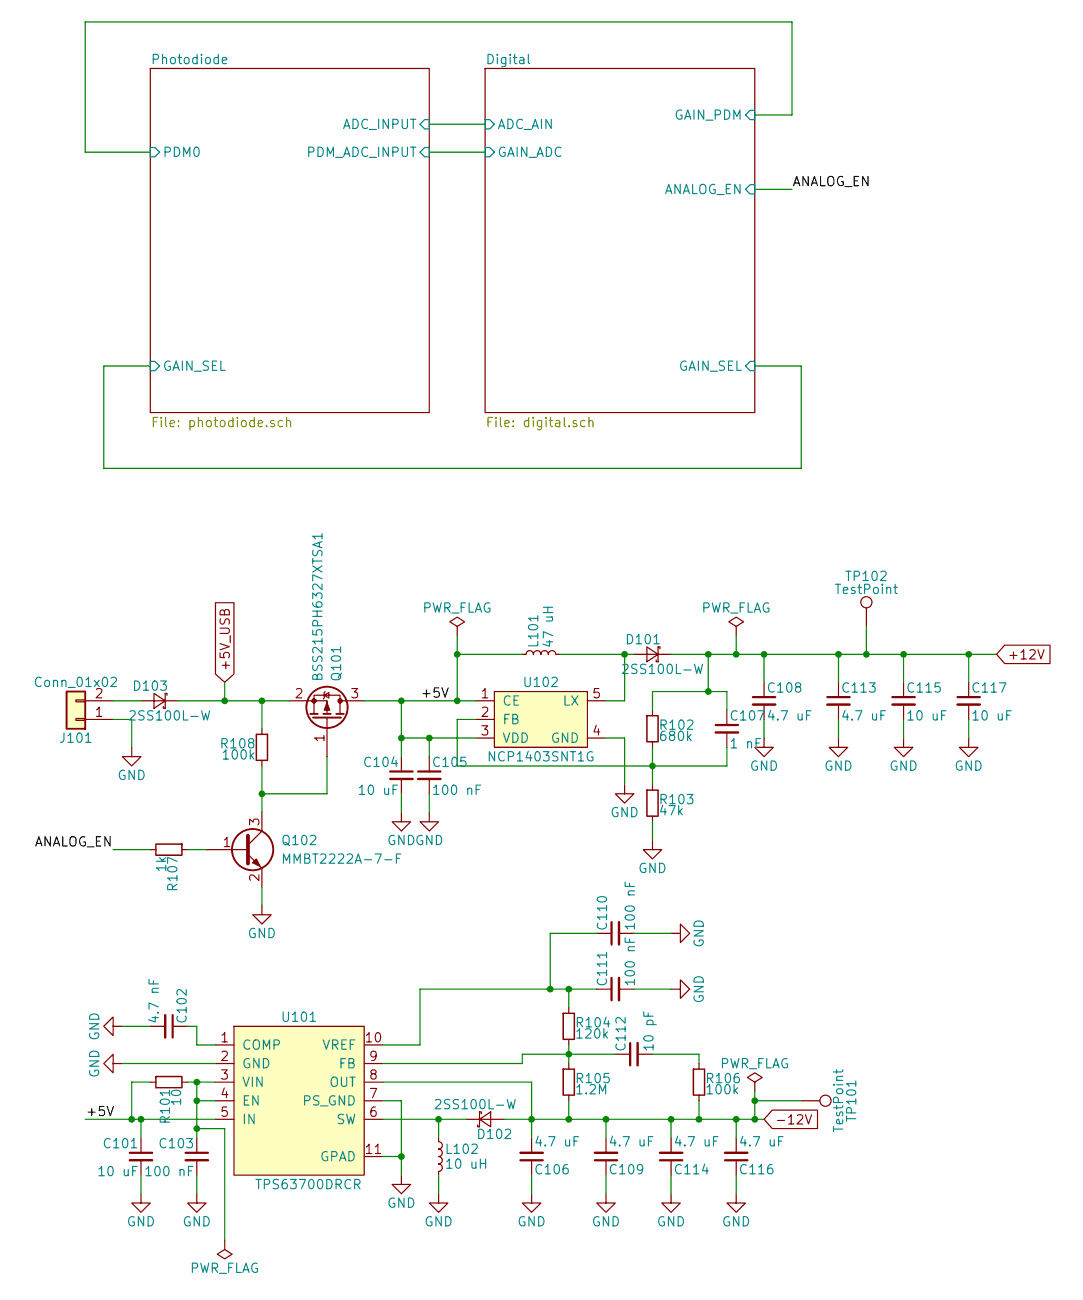
[picture p13: schematic receiver.sch]

Parts:
C101, C104, C115, C117: 10 uF; C_0805_HandSoldering; Mouser 81-GRM21BR61E106MA3L
C102: 4.7 nF; C_0402; Mouser 710-885012205029
C103, C105, C110, C111: 100 nF; C_0603_HandSoldering; Mouser 710-885012206071
C106, C108, C109, C113, C114, C116: 4.7 uF; CP_Elec_4x5.3; Mouser 647-UWX1E4R7MCL1
C107: 1 nF; C_0402; Mouser 710-885012205061
C112: 10 pF; C_0402; Mouser 710-885012005074
D101, D102, D103: 2SS100L-W; Rectron_SOD-123FL; Mouser 583-2SS100L-W
J101: Conn_01x02; Socket_Strip_Straight_1x02_Pitch2.54mm; Mouser NoPart
L101: 47 uH; C_0805_HandSoldering; Mouser 810-MLZ2012M470WT000
L102: 10 uH; C_0805_HandSoldering; Mouser 810-MLZ2012M100WT000
Q101: BSS215PH6327XTSA1; SOT-23_Handsoldering; Mouser 726-BSS215PH6327
Q102: MMBT2222A-7-F; SOT-23_Handsoldering; Mouser 621-MMBT2222A-F
R101: 10; C_0402; Mouser 667-ERJ-U02D10R0X
R102: 680k; R_0603_HandSoldering; Mouser 603-RC0603FR-13680KL
R103: 47k; R_0603_HandSoldering; Mouser 603-RC0603FR-0747KL
R104: 120k; R_0603_HandSoldering; Mouser 603-RC0603FR-07120KL
R105: 1.2M; R_0402; Mouser 603-RC0402JR-071M2L
R106, R108: 100k; R_0402; Mouser 603-RC0402JR-13100KL
R107: 1k; R_0603_HandSoldering; Mouser 603-RC0603JR-071KL
TP101, TP102: TestPoint; Measurement_Point_Round-SMD-Pad_Small; Mouser NoPart
U101: TPS63700DRCR; TI-VSON10; Mouser 595-TPS63700DRCR
U102: NCP1403SNT1G; ON-TSOP-5; Mouser 863-NCP1403SNT1G

Connections:
+5V_USB: D103.1 (K), Q101.2 (S), R108.1; also elsewhere on the board
+12V: C107.1, C108.1, C113.1, C115.1, C117.1, D101.1 (K), R102.1, TP102.1; also elsewhere on the board
-12V: C106.2, C109.2, C114.2, C116.2, D102.2 (A), R105.2, R106.2, TP101.1, U101.8 (OUT); also elsewhere on the board
/+5V: C101.1, C104.1, C105.1, L101.1, Q101.3 (D), R101.1, U101.5 (IN), U102.1 (CE), U102.3 (VDD)
/ANALOG_EN: R107.2; also elsewhere on the board
GND: C101.2, C102.2, C103.2, C104.2, C105.2, C106.1, C108.2, C109.1, C110.2, C111.2, C113.2, C114.1, C115.2, C116.1, C117.2, J101.1, L102.2, Q102.2 (E), R103.2, U101.2 (GND), U101.7 (PS_GND), U101.11 (GPAD), U102.4 (GND); also elsewhere on the board
unnamed: C102.1, U101.1 (COMP)
unnamed: C103.1, R101.2, U101.3 (VIN), U101.4 (EN)
unnamed: C107.2, R102.2, R103.1, U102.2 (FB)
unnamed: C110.1, C111.1, R104.1, U101.10 (VREF)
unnamed: C112.1, R104.2, R105.1, U101.9 (FB)
unnamed: C112.2, R106.1
unnamed: D101.2 (A), L101.2, U102.5 (LX)
unnamed: D102.1 (K), L102.1, U101.6 (SW)
unnamed: D103.2 (A), J101.2
unnamed: Q101.1 (G), Q102.3 (C), R108.2
unnamed: Q102.1 (B), R107.1
