cactorium/auto-orchestra/pcb/receiver/receiver.kicad_pcb

## KiCad design pcb/receiver/receiver.kicad_pcb (continued)

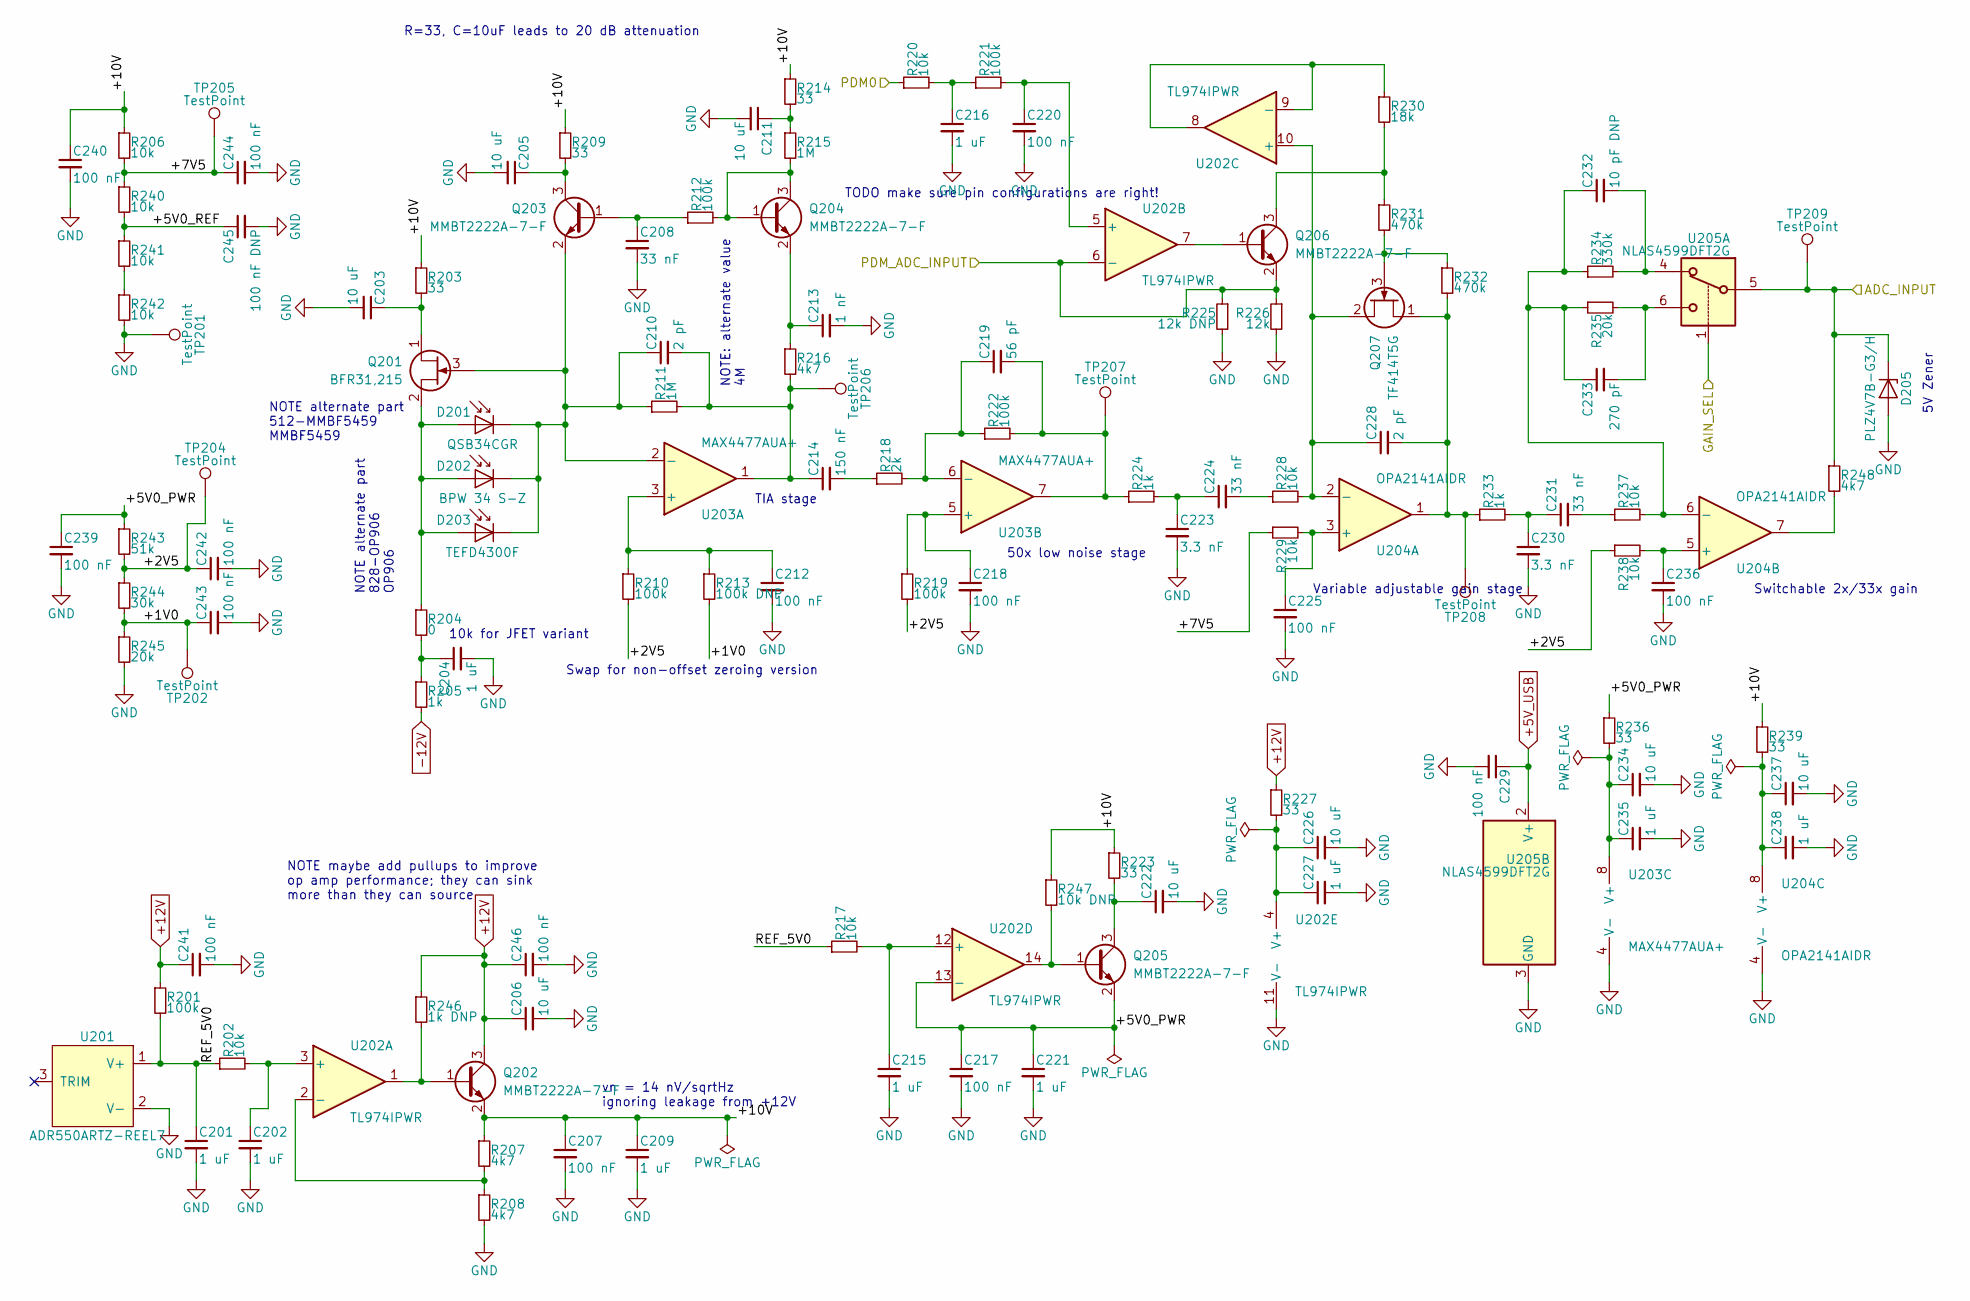
[picture p14: schematic photodiode.sch]

Parts:
C201, C202, C204, C209, C215, C216, C221, C227, C235, C238: 1 uF; C_0603_HandSoldering; Mouser 710-885012106022
C203, C205, C206, C211, C222, C226, C234, C237: 10 uF; C_0805_HandSoldering; Mouser 81-GRM21BR61E106MA3L
C207, C212, C217, C218, C220, C225, C229, C236, C239, C240, C241, C242, C243, C244, C246: 100 nF; C_0603_HandSoldering; Mouser 710-885012206071
C208, C224, C231: 33 nF; C_0402; Mouser 710-885012105014
C210, C228: 2 pF; C_0603_HandSoldering; Mouser 603-C0603BRNPO9BN2R0
C213: 1 nF; C_0402; Mouser 710-885012205061
C214: 150 nF; C_0603_HandSoldering; Mouser 710-885012206021
C219: 56 pF; C_0402; Mouser 77-VJ0402A560KXAPBC
C223, C230: 3.3 nF; C_0603_HandSoldering; Mouser 77-VJ0402A560KXAPBC
C232: 10 pF DNP; C_0402; Mouser 710-885012005074
C233: 270 pF; C_0402; Mouser 963-UMK105CH271JVHF
C245: 100 nF DNP; C_0603_HandSoldering; Mouser 710-885012206071
D201: QSB34CGR; Fairchild_QSB34CGR; Mouser 512-QSB34CGR
D202: BPW 34 S-Z; OSRAM_BPW34S-Z; Mouser 720-BPW34S-Z
D203: TEFD4300F; LED_D3.0mm; Mouser 78-TEFD4300F
D205: PLZ4V7B-G3/H; Vishay_DO-219AC; Mouser 78-PLZ4V7B-G3/H
Q201: BFR31,215; SOT-23_Handsoldering; Mouser 771-BFR31215
Q202, Q203, Q204, Q205, Q206: MMBT2222A-7-F; SOT-23_Handsoldering; Mouser 621-MMBT2222A-F
Q207: TF414T5G; ON_XDFN3; Mouser 863-TF414T5G
R201, R210, R212, R219, R221, R222: 100k; R_0402; Mouser 603-RC0402JR-13100KL
R202, R206, R217, R220, R228, R229, R237, R238, R240, R241, R242: 10k; R_0603_HandSoldering; Mouser 603-RC0603FR-0710KL
R203, R209, R214, R223, R227, R236, R239: 33; R_0603_HandSoldering; Mouser 755-ESR03EZPJ330
R204: 0; R_0603_HandSoldering; Mouser 755-SFR03EZPJ000
R205, R224, R233: 1k; R_0603_HandSoldering; Mouser 603-RC0603JR-071KL
R207, R208, R216, R248: 4k7; R_0603_HandSoldering; Mouser 71-CRCW06034K70JNEAC
R211, R215: 1M; R_0603_HandSoldering; Mouser 603-RC0603JR-071ML
R213: 100k DNP; R_0402; Mouser 603-RC0402JR-13100KL
R218: 2k; R_0603_HandSoldering; Mouser 603-RC0603FR-102KL
R225: 12k DNP; R_0603_HandSoldering; Mouser 603-RC0603FR-1012KL
R226: 12k; R_0603_HandSoldering; Mouser 603-RC0603FR-1012KL
R230: 18k; R_0603_HandSoldering; Mouser 603-RC0603FR-0718KL
R231, R232: 470k; R_0603_HandSoldering; Mouser 603-RC0603FR-07470KL
R234: 330k; R_0402; Mouser 603-RC0402FR-07330KL
R235, R245: 20k; R_0402; Mouser 755-SFR01MZPF2002
R243: 51k; R_0402; Mouser 603-RC0402FR-0751KL
R244: 30k; R_0402; Mouser 603-AC0402FR-0730KL
R246: 1k DNP; R_0603_HandSoldering; Mouser 603-RC0603JR-071KL
R247: 10k DNP; R_0603_HandSoldering; Mouser 603-RC0603FR-0710KL
TP201, TP202, TP204, TP205, TP206, TP207, TP208, TP209: TestPoint; Measurement_Point_Round-SMD-Pad_Small; Mouser NoPart
U201: ADR550ARTZ-REEL7; SOT-23_Handsoldering; Mouser 584-ADR550ARTZ-R7
U202: TL974IPWR; TI-SOIC14; Mouser 595-TL974IPWR
U203: MAX4477AUA+; Maxim-uMAX8; Mouser 700-MAX4477AUA
U204: OPA2141AIDR; TI-SOIC8; Mouser 595-OPA2141AIDR
U205: NLAS4599DFT2G; On-SOT363; Mouser 863-NLAS4599DFT2G

Connections:
+5V_USB: C229.1, U205.2 (V+); also elsewhere on the board
+12V: C206.1, C241.1, C246.1, Q202.3 (C), R201.1, R227.1, R246.1; also elsewhere on the board
-12V: R205.2; also elsewhere on the board
/Digital/ADC_AIN: D205.1 (K), R248.1, TP209.1, U205.5; also elsewhere on the board
/Digital/GAIN_ADC: Q206.2 (E), R225.1, R226.1, U202.6 (-); also elsewhere on the board
/Digital/GAIN_PDM: R220.1; also elsewhere on the board
/Digital/GAIN_SEL: U205.1; also elsewhere on the board
/Photodiode/+1V0: C243.1, R213.2, R244.2, R245.1, TP202.1
/Photodiode/+2V5: C242.1, R210.2, R219.2, R238.1, R243.2, R244.1, TP204.1
/Photodiode/+5V0_PWR: C217.1, C221.1, C239.1, Q205.2 (E), R236.1, R243.1, U202.13 (-)
/Photodiode/+5V0_REF: C245.1, R240.2, R241.1
/Photodiode/+7V5: C244.1, R206.2, R229.1, R240.1, TP205.1
/Photodiode/+10V: C207.1, C209.1, C240.1, Q202.2 (E), R203.1, R206.1, R207.1, R209.1, R214.1, R223.1, R239.1, R247.1
/Photodiode/REF_5V0: C201.1, R201.2, R202.1, R217.1, U201.1 (V+)
GND: C201.2, C202.2, C203.2, C204.2, C205.2, C206.2, C207.2, C208.2, C209.2, C211.2, C212.2, C213.2, C215.2, C216.2, C217.2, C218.2, C220.2, C221.2, C222.2, C223.2, C225.2, C226.2, C227.2, C229.2, C230.2, C234.2, C235.2, C236.2, C237.2, C238.2, C239.2, C240.2, C241.2, C242.2, C243.2, C244.2, C245.2, C246.2, D205.2 (A), R208.2, R225.2, R226.2, R242.2, R245.2, TP201.1, U201.2 (V-), U202.11 (V-), U203.4 (V-), U204.4 (V-), U205.3 (GND); also elsewhere on the board
unnamed: C202.1, R202.2, U202.3 (+)
unnamed: C203.1, Q201.1 (D), R203.2
unnamed: C204.1, R204.2, R205.1
unnamed: C205.1, Q203.3 (C), R209.2
unnamed: C208.1, Q203.1 (B), R212.1
unnamed: C210.1, D201.1 (K), D202.1 (K), D203.1 (K), Q201.3 (G), Q203.2 (E), R211.1, U203.2 (-)
unnamed: C210.2, C214.1, R211.2, R216.2, TP206.1, U203.1
unnamed: C211.1, R214.2, R215.1
unnamed: C212.1, R210.1, R213.1, U203.3 (+)
unnamed: C213.1, Q204.2 (E), R216.1
unnamed: C214.2, R218.1
unnamed: C215.1, R217.2, U202.12 (+)
unnamed: C216.1, R220.2, R221.1
unnamed: C218.1, R219.1, U203.5 (+)
unnamed: C219.1, R218.2, R222.1, U203.6 (-)
unnamed: C219.2, R222.2, R224.1, TP207.1, U203.7
unnamed: C220.1, R221.2, U202.5 (+)
unnamed: C222.1, Q205.3 (C), R223.2
unnamed: C223.1, C224.1, R224.2
unnamed: C224.2, R228.1
unnamed: C225.1, R229.2, U204.3 (+)
unnamed: C226.1, C227.1, R227.2, U202.4 (V+)
unnamed: C228.1, Q207.2 (D), R228.2, U202.10 (+), U204.2 (-)
unnamed: C228.2, Q207.1 (S), R232.2, R233.1, TP208.1, U204.1
unnamed: C230.1, C231.1, R233.2
unnamed: C231.2, R237.1
unnamed: C232.1, C233.1, R234.1, R235.1, R237.2, U204.6 (-)
unnamed: C232.2, R234.2, U205.4
unnamed: C233.2, R235.2, U205.6
unnamed: C234.1, C235.1, R236.2, U203.8 (V+)
unnamed: C236.1, R238.2, U204.5 (+)
unnamed: C237.1, C238.1, R239.2, U204.8 (V+)
unnamed: D201.2 (A), D202.2 (A), D203.2 (A), Q201.2 (S), R204.1
unnamed: Q202.1 (B), R246.2, U202.1
unnamed: Q204.1 (B), Q204.3 (C), R212.2, R215.2
unnamed: Q205.1 (B), R247.2, U202.14
unnamed: Q206.1 (B), U202.7
unnamed: Q206.3 (C), R230.2, R231.1
unnamed: Q207.3 (G), R231.2, R232.1
unnamed: R207.2, R208.1, U202.2 (-)
unnamed: R230.1, U202.8, U202.9 (-)
unnamed: R241.2, R242.1
unnamed: R248.2, U204.7

Notes on the sheet:
10k for JFET variant
TODO make sure pin configurations are right!
50x low noise stage
TIA stage
Variable adjustable gain stage
Switchable 2x/33x gain
Swap for non-offset zeroing version
R=33, C=10uF leads to 20 dB attenuation
vn = 14 nV/sqrtHz ignoring leakage from +12V
NOTE maybe add pullups to improve op amp performance; they can sink more than they can source
5V Zener
NOTE alternate part 512-MMBF5459 MMBF5459
NOTE: alternate value 4M
NOTE alternate part 828-OP906 OP906

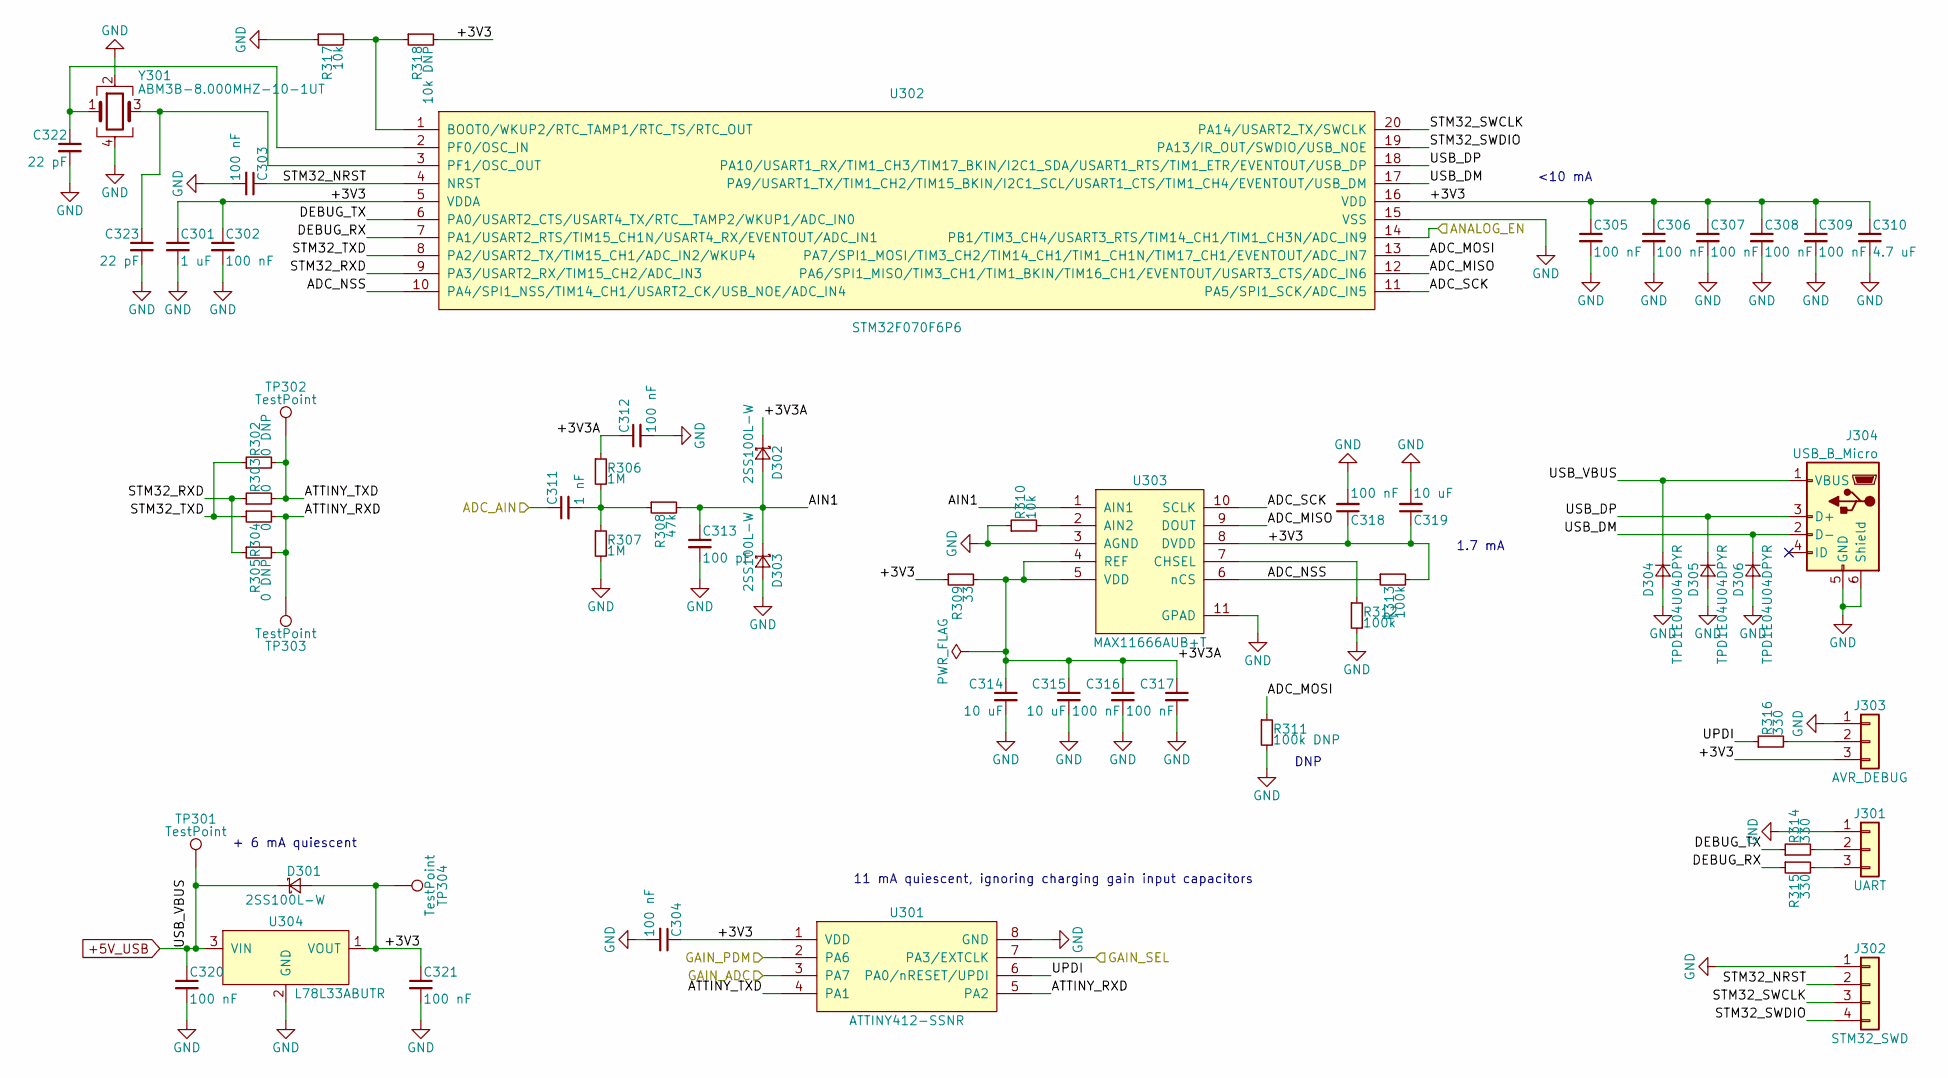
[picture p15: schematic digital.sch]

Parts:
C301: 1 uF; C_0603_HandSoldering; Mouser 710-885012106022
C302, C303, C304, C305, C306, C307, C308, C309, C312, C316, C317, C318, C320, C321: 100 nF; C_0603_HandSoldering; Mouser 710-885012206071
C310: 4.7 uF; CP_Elec_4x5.3; Mouser 647-UWX1E4R7MCL1
C311: 1 nF; C_0402; Mouser 710-885012205061
C313: 100 pF; C_0402; Mouser 963-UMK105CH101JVHF
C314, C315, C319: 10 uF; C_0805_HandSoldering; Mouser 81-GRM21BR61E106MA3L
C322, C323: 22 pF; C_0402; Mouser 710-885012005009
D301, D302, D303: 2SS100L-W; Rectron_SOD-123FL; Mouser 583-2SS100L-W
D304, D305, D306: TPD1E04U04DPYR; TI_X1SON; Mouser 595-TPD1E04U04DPYR
J301: UART; Socket_Strip_Straight_1x03_Pitch2.54mm; Mouser NoPart
J302: STM32_SWD; Socket_Strip_Straight_2x02_Pitch2.54mm; Mouser NoPart
J303: AVR_DEBUG; Socket_Strip_Straight_1x03_Pitch2.54mm; Mouser NoPart
J304: USB_B_Micro; Amphenol_10118194; Mouser 649-10118194-0001LF
R302, R305: 0 DNP; R_0603_HandSoldering; Mouser 755-SFR03EZPJ000
R303, R304: 0; R_0603_HandSoldering; Mouser 755-SFR03EZPJ000
R306, R307: 1M; R_0603_HandSoldering; Mouser 603-RC0603JR-071ML
R308: 47k; R_0603_HandSoldering; Mouser 603-RC0603FR-0747KL
R309: 33; R_0603_HandSoldering; Mouser 755-ESR03EZPJ330
R310, R317: 10k; R_0603_HandSoldering; Mouser 603-RC0603FR-0710KL
R311: 100k DNP; R_0402; Mouser 603-RC0402JR-13100KL
R312, R313: 100k; R_0402; Mouser 603-RC0402JR-13100KL
R314, R315, R316: 330; R_0402; Mouser 603-RC0402JR-7D330RL
R318: 10k DNP; R_0603_HandSoldering; Mouser 603-RC0603FR-0710KL
TP301, TP302, TP303, TP304: TestPoint; Measurement_Point_Round-SMD-Pad_Small; Mouser NoPart
U301: ATTINY412-SSNR; Atmel-SOIC150-8; Mouser 556-ATTINY412-SSNR
U302: STM32F070F6P6; ST-TSSOP20; Mouser 511-STM32F070F6P6
U303: MAX11666AUB+T; Maxim-U10E+3; Mouser 700-MAX11666AUB+T
U304: L78L33ABUTR; SOT-89-3_Handsoldering; Mouser 511-L78L33ABU-TR
Y301: ABM3B-8.000MHZ-10-1UT; Crystal_SMD_Abracon_ABM3C-4pin_5.0x3.2mm; Mouser 815-ABM3B-8.0-10-1UT

Connections:
+5V_USB: C320.1, D301.1 (K), D304.1 (K), J304.1 (VBUS), TP301.1, U304.3 (VIN); also elsewhere on the board
/ANALOG_EN: U302.14 (PB1/TIM3_CH4/USART3_RTS/TIM14_CH1/TIM1_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); also elsewhere on the board
/Digital/+3V3: C301.1, C302.1, C304.1, C305.1, C306.1, C307.1, C308.1, C309.1, C310.1, C318.1, C319.1, C321.1, D301.2 (A), J303.3, R309.1, R313.2, R318.2, TP304.1, U301.1 (VDD), U302.5 (VDDA), U302.16 (VDD), U303.8 (DVDD), U304.1 (VOUT)
/Digital/+3V3A: C312.1, C314.1, C315.1, C316.1, C317.1, D302.1 (K), R306.1, R309.2, U303.4 (REF), U303.5 (VDD)
/Digital/ADC_AIN: C311.1; also elsewhere on the board
/Digital/ADC_MISO: U302.12 (PA6/SPI1_MISO/TIM3_CH1/TIM1_BKIN/TIM16_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), U303.9 (DOUT)
/Digital/ADC_MOSI: R311.1, U302.13 (PA7/SPI1_MOSI/TIM3_CH2/TIM14_CH1/TIM1_C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)
/Digital/ADC_NSS: R313.1, U302.10 (PA4/SPI1_NSS/TIM14_CH1/USART2_CK/USB_NO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), U303.6 (nCS)
/Digital/ADC_SCK: U302.11 (PA5/SPI1_SCK/ADC_IN5), U303.10 (SCLK)
/Digital/AIN1: C313.1, D302.2 (A), D303.1 (K), R308.2, U303.1 (AIN1)
/Digital/ATTINY_RXD: R304.2, R305.2, TP303.1, U301.5 (PA2)
/Digital/ATTINY_TXD: R302.2, R303.2, TP302.1, U301.4 (PA1)
/Digital/DEBUG_RX: R315.1, U302.7 (PA1/USART2_RTS/TIM15_CH1N/USART4_RX/EVE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)
/Digital/DEBUG_TX: R314.1, U302.6 (PA0/USART2_CTS/USART4_TX/RTC__TAMP2/WKU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)
/Digital/GAIN_ADC: U301.3 (PA7); also elsewhere on the board
/Digital/GAIN_PDM: U301.2 (PA6); also elsewhere on the board
/Digital/GAIN_SEL: U301.7 (PA3/EXTCLK); also elsewhere on the board
/Digital/STM32_NRST: C303.1, J302.2, U302.4 (NRST)
/Digital/STM32_RXD: R303.1, R305.1, U302.9 (PA3/USART2_RX/TIM15_CH2/ADC_IN3)
/Digital/STM32_SWCLK: J302.3, U302.20 (PA14/USART2_TX/SWCLK)
/Digital/STM32_SWDIO: J302.4, U302.19 (PA13/IR_OUT/SWDIO/USB_NOE)
/Digital/STM32_TXD: R302.1, R304.1, U302.8 (PA2/USART2_TX/TIM15_CH1/ADC_IN2/WKUP4)
/Digital/UPDI: R316.1, U301.6 (PA0/nRESET/UPDI)
/Digital/USB_DM: D306.1 (K), J304.2 (D-), U302.17 (PA9/USART1_TX/TIM1_CH2/TIM15_BKIN/I2C1_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)
/Digital/USB_DP: D305.1 (K), J304.3 (D+), U302.18 (PA10/USART1_RX/TIM1_CH3/TIM17_BKIN/I2C1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)
GND: C301.2, C302.2, C303.2, C304.2, C305.2, C306.2, C307.2, C308.2, C309.2, C310.2, C312.2, C313.2, C314.2, C315.2, C316.2, C317.2, C318.2, C319.2, C320.2, C321.2, C322.2, C323.2, D303.2 (A), D304.2 (A), D305.2 (A), D306.2 (A), J301.1, J302.1, J303.1, J304.5 (GND), J304.6 (Shield), R307.2, R310.1, R311.2, R312.2, R317.1, U301.8 (GND), U302.15 (VSS), U303.3 (AGND), U303.11 (GPAD), U304.2 (GND), Y301.2, Y301.4; also elsewhere on the board
unnamed: C311.2, R306.2, R307.1, R308.1
unnamed: C322.1, U302.2 (PF0/OSC_IN), Y301.1
unnamed: C323.1, U302.3 (PF1/OSC_OUT), Y301.3
unnamed: J301.2, R314.2
unnamed: J301.3, R315.2
unnamed: J303.2, R316.2
unnamed: R310.2, U303.2 (AIN2)
unnamed: R312.1, U303.7 (CHSEL)
unnamed: R317.2, R318.1, U302.1 (BOOT0/WKUP2/RTC_TAMP1/RTC_TS/RTC_OUT)

Notes on the sheet:
11 mA quiescent, ignoring charging gain input capacitors
<10 mA
1.7 mA
+ 6 mA quiescent
DNP

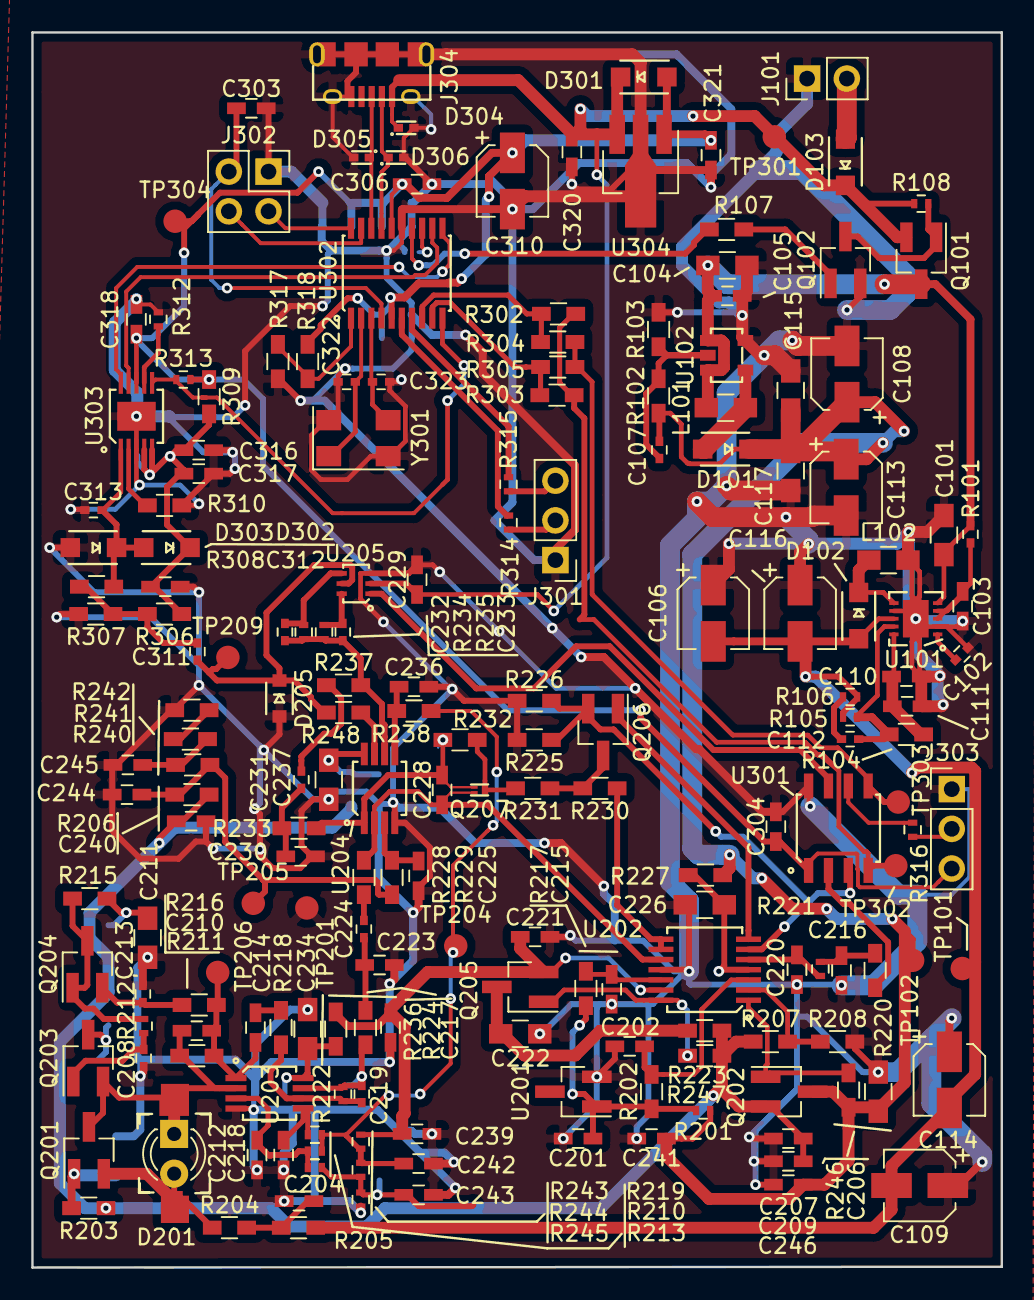
[picture p16: board receiver.kicad_pcb from above]

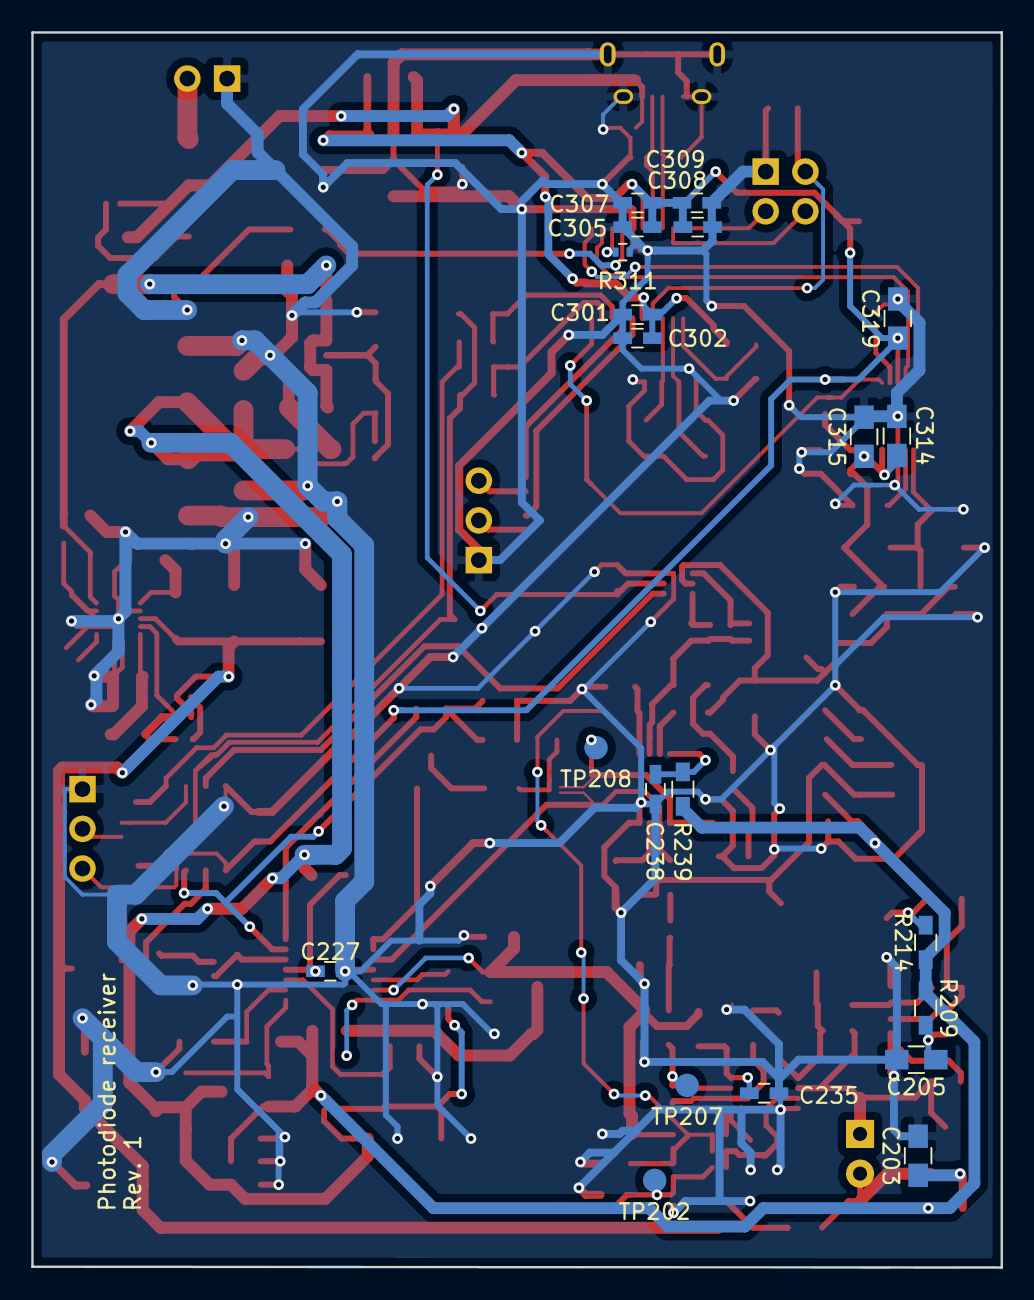
[picture p17: board receiver.kicad_pcb from below]

Board: 2 copper layers, 62.0 x 79.0 mm, 214 parts (21 on the bottom side), 99 nets.
