cactorium/auto-orchestra/pcb/rs485/rs485.kicad_pcb

## KiCad design pcb/rs485/rs485.kicad_pcb (2018-08-16)

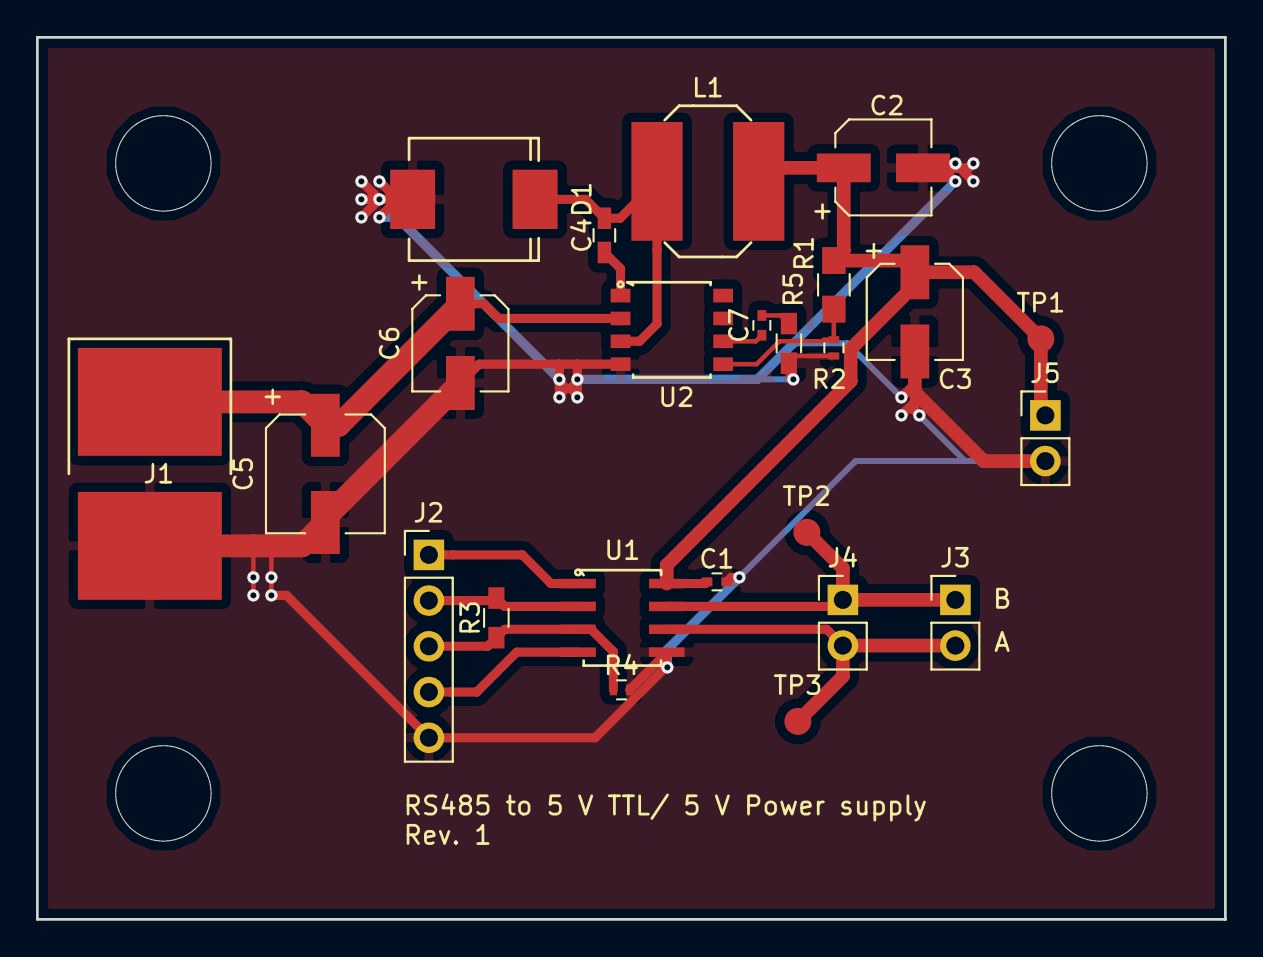
[picture p18: board rs485.kicad_pcb from above]

Board: 2 copper layers, 66.0 x 49.0 mm, 28 parts (0 on the bottom side), 14 nets.

Parts:
C1: 100nF; C_0402
C2: 100uF; CP_Elec_5x5.3
C3, C6: 10uF; CP_Elec_5x5.7
C4: 10nF; C_0603_HandSoldering
C5: 47uF; CP_Elec_6.3x5.8
C7: 2.2nF; C_0402
D1: VS-MBRS340-M39AT; Wickerlib-DIODE-SMC-DO214AB
J1: Power; Conn-2-8mmx6mm
J2: Conn_01x05; Socket_Strip_Straight_1x05_Pitch2.54mm
J3, J4, J5: Conn_01x02; Socket_Strip_Straight_1x02_Pitch2.54mm
L1: 33uH; Inductor-Bourns-SRN8040TA
MH1, MH2, MH3, MH4: MountingHole; MountingHole_5.3mm_M5
R1: 52k; R_0805_HandSoldering
R2, R4: 10k; R_0402
R3: 0; R_0603_HandSoldering
R5: 12k; R_0603_HandSoldering
TP1, TP2, TP3: TestPoint; Measurement_Point_Round-SMD-Pad_Small
U1: SP485CN-L_TR; Exar-NSOIC8
U2: ACT4065A; ActiveSemi-SOP8

Connections:
/+5V: C1.1, C2.1, C3.1, J5.1, L1.2, R1.1, TP1.1, U1.8
GND: C1.2, C2.2, C3.2, C5.2, C6.2, D1.2, J1.2, J2.5, J5.2, R2.2, R4.2, R5.2, U1.5, U2.4
unnamed: C4.1, U2.1
unnamed: C4.2, D1.1, L1.1, U2.3
unnamed: C5.1, C6.1, J1.1, U2.2
unnamed: C7.1, U2.6
unnamed: C7.2, R5.1
unnamed: J2.1, U1.1
unnamed: J2.2, R3.2, U1.2
unnamed: J2.3, R3.1, R4.1, U1.3
unnamed: J2.4, U1.4
unnamed: J3.1, J4.1, TP2.1, U1.7
unnamed: J3.2, J4.2, TP3.1, U1.6
unnamed: R1.2, R2.1, U2.5
