cactorium/auto-orchestra/(commit log)

2018-08-11 Start work on stuff; finish half H bridge
    [peripherals.kicad_pcb, peripherals.sch]
2018-08-11 Save before autofill
    [half-h.sch, peripherals.sch]
2018-08-11 Schematic done; TODO add footprints for connectors
    [half-h.sch, peripherals.sch]
2018-08-12 Save before messing with tiler script
    [half-h.sch, peripherals.sch]
2018-08-13 Save before tiling
    [peripherals.kicad_pcb]
2018-08-13 python tile_pcb.py peripherals.kicad_pcb 3 2,4-9 0.0 30.0
    [peripherals.kicad_pcb]
2018-08-13 Save before debugging weird netlist buggery
    [peripherals.kicad_pcb]
2018-08-13 Fix bad pad net labeling in tile_pcb.py; python tile_pcb.py peripherals.kicad_pcb 2 3-9 0.0 30.0
    [peripherals.kicad_pcb]
2018-08-13 Save before testing auto_tile.py
    [peripherals.kicad_pcb]
2018-08-13 Autotiling probably works now, aside from breaking from the sheet stuff probably
    [peripherals.kicad_pcb]
2018-08-13 Save before autotiling
    [peripherals.kicad_pcb]
2018-08-13 python autotile_pcb.py peripherals.kicad_pcb 2 3-9 48.3 63.8 79.9 92.7 0.0 30.0 plus some layout work
    [peripherals.kicad_pcb]
2018-08-14 Layout finished and Gerbers generated
    [half-h.sch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]
2018-08-14 Generate motor driver BOM
    [peripherals-bom.csv, peripherals-mouser.csv]
2018-08-15 Hopefully all components sourced
    [rs485.kicad_pcb, rs485.sch]
2018-08-15 Finish layout
    [rs485-B.Cu.gbl, rs485-B.Fab.gbr, rs485-B.Mask.gbs, rs485-B.Paste.gbp, rs485-B.SilkS.gbo, rs485-Edge.Cuts.gm1, rs485-F.Cu.gtl, rs485-F.Fab.gbr]
2018-08-15 Add silkscreen name
    [rs485-B.Cu.gbl, rs485-B.Fab.gbr, rs485-B.Mask.gbs, rs485-B.Paste.gbp, rs485-B.SilkS.gbo, rs485-Edge.Cuts.gm1, rs485-F.Cu.gtl, rs485-F.Fab.gbr]
2018-08-16 Generate BOMs
    [rs485-bom.csv, rs485-mouser.csv, rs485.kicad_pcb, rs485.sch]
2018-08-31 Finish schematic, TODO footprinting
    [controller.kicad_pcb, controller.sch]
2018-08-31 Autofill passives
    [controller.sch]
2018-09-02 Add footprints
    [controller-bom.csv, controller-mouser.csv, controller.sch]
2018-09-03 All parts (I think?) sourced and footprinted
    [controller.sch]
2018-09-03 Now all parts footprinted and sourced
    [controller.sch]
2018-09-03 Finish layout and generate Gerbers
    [controller-B.Cu.gbl, controller-B.Fab.gbr, controller-B.Mask.gbs, controller-B.Paste.gbp, controller-B.SilkS.gbo, controller-Edge.Cuts.gm1, controller-F.Cu.gtl, controller-F.Fab.gbr]
2018-09-04 Resize vias
    [controller-B.Cu.gbl, controller-B.Fab.gbr, controller-B.Mask.gbs, controller-B.Paste.gbp, controller-B.SilkS.gbo, controller-Edge.Cuts.gm1, controller-F.Cu.gtl, controller-F.Fab.gbr]
2018-10-12 python2 ~/repos/InteractiveHtmlBom/generate_interactive_bom.py peripherals.kicad_pcb
2018-10-13 Save before autotile
    [half-h.sch, peripherals.kicad_pcb, peripherals.sch]
2018-10-13 python autotile_pcb.py peripherals.kicad_pcb 3 2,4-9 47.1 65.8 63.8 77.1 0.0 15.0 also fix autotile_pcb.py to work for Kicad5
2018-10-13 Autotile again, with copying of global traces/vias enabled
    [peripherals.kicad_pcb]
2018-10-13 Disable the thing I just did because it wasn't correct
    [peripherals.kicad_pcb]
2018-11-09 Redesign peripheral PCB, simulate photodiode circuit
    [half-h.sch, peripherals.kicad_pcb, peripherals.sch]
2018-11-23 Add simulation results
    [controller.sch, receiver.kicad_pcb, receiver.sch, tia_offset.sch]
2018-11-28 Work out signal processing and power sections TODO MCU stuff
    [Power.sch, digital.sch, photodiode.sch, receiver.sch]
2018-11-28 Simulate interstage bandpass filter; performance looks good enough
2018-12-02 Add all components TODO footprint/source everything
    [digital.sch, receiver.sch]
2018-12-02 Most parts footprinted; TODO analog voltage reference, photodiodes, passives
    [digital.sch, photodiode.sch, receiver.sch]
2018-12-03 Source most passives; save before autofill
    [digital.sch, photodiode.sch, receiver.sch]
2018-12-03 Autofill components
    [digital.sch, photodiode.sch, receiver.sch]
2018-12-04 Footprint more stuff
    [digital.sch, photodiode.sch, receiver.sch]
2018-12-04 Finish footprinting/sourcing all components
    [digital.sch, photodiode.sch, receiver.sch]
2018-12-04 Most of the layout done TODO add test points for +12V, AVR_UART, various amplifier stage outputs
    [digital.sch, photodiode.sch, receiver.kicad_pcb, receiver.sch]
2018-12-05 Add copper fills and outline, autofill test point footprints, TODO finish placing test points and moving silkscreen
    [digital.sch, photodiode.sch, receiver.kicad_pcb, receiver.sch]
2018-12-05 Finish silkscreen stuff
    [photodiode.sch, receiver.kicad_pcb]
2018-12-05 (v1) generate Gerbers
    [receiver-B.Cu.gbl, receiver-B.Fab.gbr, receiver-B.Mask.gbs, receiver-B.Paste.gbp, receiver-B.SilkS.gbo, receiver-Edge.Cuts.gm1, receiver-F.Cu.gtl, receiver-F.Fab.gbr]
2018-12-05 Generate BOM TODO fix gen_mouser.py so that it supports commas in components values correctly
    [receiver-bom.csv, receiver-mouser.csv]
2018-12-05 Regenerate Gerbers
    [peripherals-B.Cu.gbl, peripherals-B.Fab.gbr, peripherals-B.Mask.gbs, peripherals-B.Paste.gbp, peripherals-B.SilkS.gbo, peripherals-Edge.Cuts.gm1, peripherals-F.Cu.gtl, peripherals-F.Fab.gbr]
2018-12-05 Small changes/add receiver zip
    [controller.kicad_pcb]
2018-12-08 (Rev 2) Finish relayout; add load switch and upgrade protection FET, add filter resistors to digital power rails TODO fix up silkscreen
    [controller-B.Cu.gbl, controller-B.Fab.gbr, controller-B.Mask.gbs, controller-B.Paste.gbp, controller-B.SilkS.gbo, controller-Edge.Cuts.gm1, controller-F.Cu.gtl, controller-F.Fab.gbr]
2018-12-09 Finish silkscreen layout
    [controller.kicad_pcb, controller.sch]
2018-12-09 Generate Gerbers
    [controller-B.Cu.gbl, controller-B.Fab.gbr, controller-B.Mask.gbs, controller-B.Paste.gbp, controller-B.SilkS.gbo, controller-Edge.Cuts.gm1, controller-F.Cu.gtl, controller-F.Fab.gbr]
2018-12-11 Generate interactive BOM
2018-12-11 Updated generated interactive BOM
2018-12-11 Zip transmitter Gerber files for rev 2
    [controller-B.Cu.gbl, controller-B.Fab.gbr, controller-B.Mask.gbs, controller-B.Paste.gbp, controller-B.SilkS.gbo, controller-Edge.Cuts.gm1, controller-F.Cu.gtl, controller-F.Fab.gbr]
2018-12-28 I guess I modified some of the schematics somewhere?
    [controller-bom.csv, controller-mouser.csv, controller.sch, receiver.sch]
2018-12-28 Interrupt-based UART messaging seems to be working
2018-12-29 Working ADC stuff
2018-12-30 Fix missing UART messages, it really doesn't like constant strings so use a different integer encoding
    [pdm.c]
2018-12-30 Note missing components
    [digital.sch, photodiode.sch]
2019-01-12 Fix Makefile to work with FT23322H / Arduino Pro Mini programmer
2019-01-13 Stableish control loop; still ~50mV of noise, but this is probably good enough
    [pdm.c]
2019-01-13 Reduce gain a little to improve error maybe; multimeter seems to be messing with measurements
    [pdm.c]
2019-01-17 Add in TODOs for a lot of small mistakes
    [digital.sch, photodiode.sch]
2019-01-22 First test at receiver firmware; let's see if USB works (TODO test)
    [receiver.cfg]
2019-01-23 Switch back to HSE
2019-01-23 Remap pins; still not working
    [main.c]
2019-01-23 Add note about ESD diodes
    [digital.sch]
2019-01-24 Split USB code into separate file, working timer
2019-01-25 Add more utils for testing out ADC
2019-01-26 Fix bug in usart_write, test out accelerometer (failed; guessing the soldering didn't work)
    [main.c]
2019-01-27 Increase the sample rate to 100 kHz for now
2019-01-27 Add note for swapping out power supply op amp
    [photodiode.sch]
2019-01-27 Swap out FSK for BPSK; should be easier to decode
    [main.c]
2019-01-27 Accelerometers are working! Add code to process accelerometer data, start work on carrier recovery at ADC
2019-01-27 Fix ADC timing issue; sampling rate was lower than expected
    [main.c]
2019-01-28 Collect some samples for carrier recovery testing
2019-01-28 Start work on carrier recovery and rename samples
2019-01-29 Add final stage LPF and make scatter plot selectable as an option
2019-01-29 Add dump IQ option to chain with a line decoder
2019-01-31 Looks like the issue might be buffer overflow in the TX firmware; the last couple bytes seem to get overwritten pretty often, and the timing seems to support this
2019-02-08 Refactor out offset code, fix bug with track players where the last note would play forever if the player was started during a note
